alx-1/technologies-de-la-fete/images/TTGO_esp32_pinouts.png

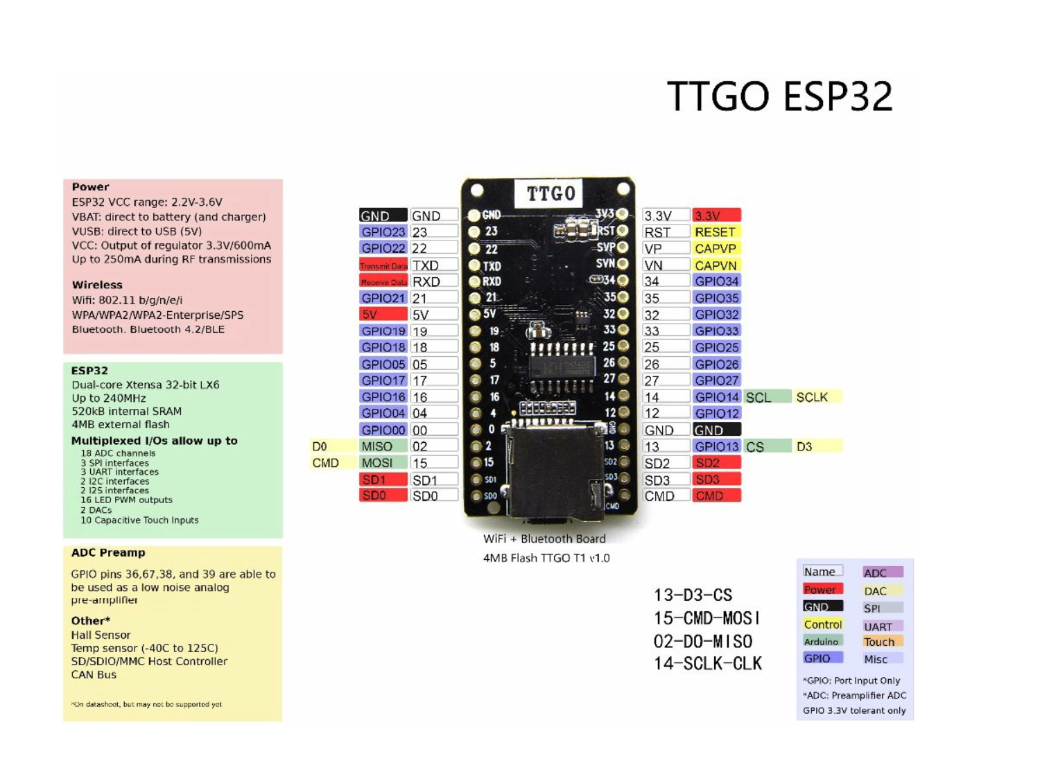
images/TTGO_esp32_pinouts.png
