alx-1/technologies-de-la-fete/README.md

# technologies-de-la-fete

# The project has moved here : https://gitlab.com/tdlf

ESP32 Ableton Link Midi clock, sensor interface and modular sequencer.

Wiki : https://github.com/alx-1/technologies-de-la-fete/wiki
