alx-1/technologies-de-la-fete/software/link_tdlf_client/README.md

# Ableton Link on ESP32 send midi data to server

16 step wireless modular sequencer 
sends midi data via socket
Uses smart config, need the app from Espressif to configure the IP

Tested with esp-idf release/v4.0.

Based on the ESP32 Ableton Link port by Mathias Bredholt https://github.com/mathiasbredholt/link-esp
