alx-1/technologies-de-la-fete/images/ESPTOUCH.PNG

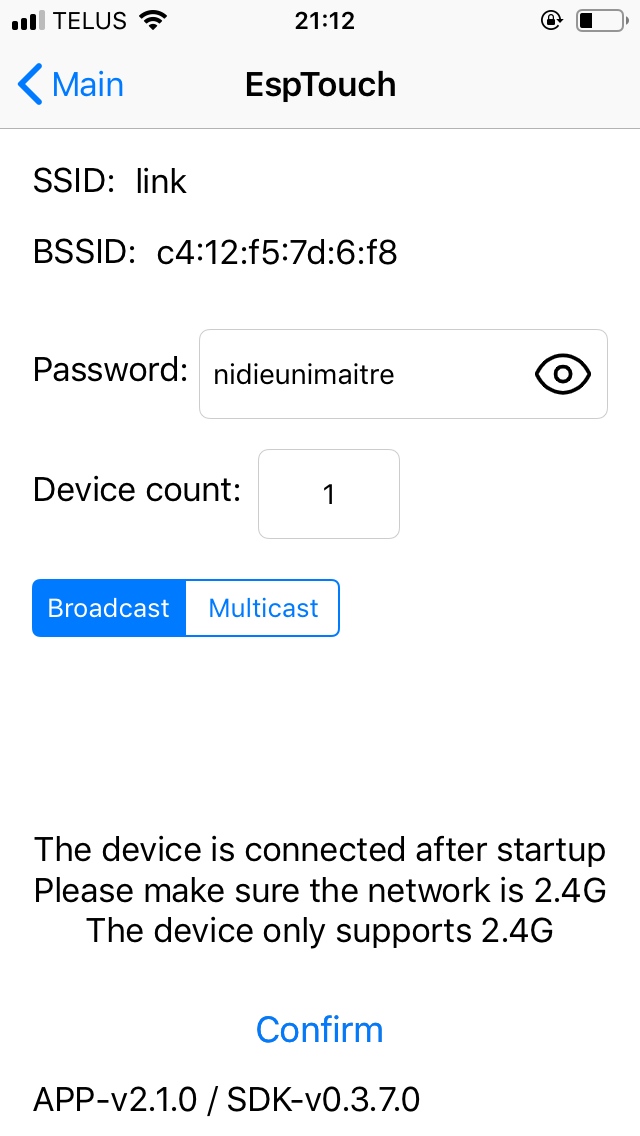
images/ESPTOUCH.PNG
