alx-1/technologies-de-la-fete/images/link_tdlf_client_3D.png

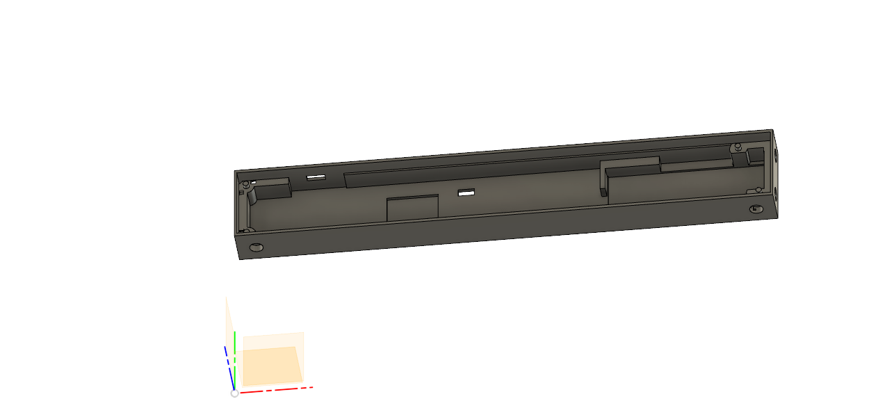
images/link_tdlf_client_3D.png
