alx-1/technologies-de-la-fete/images/midi_data.png

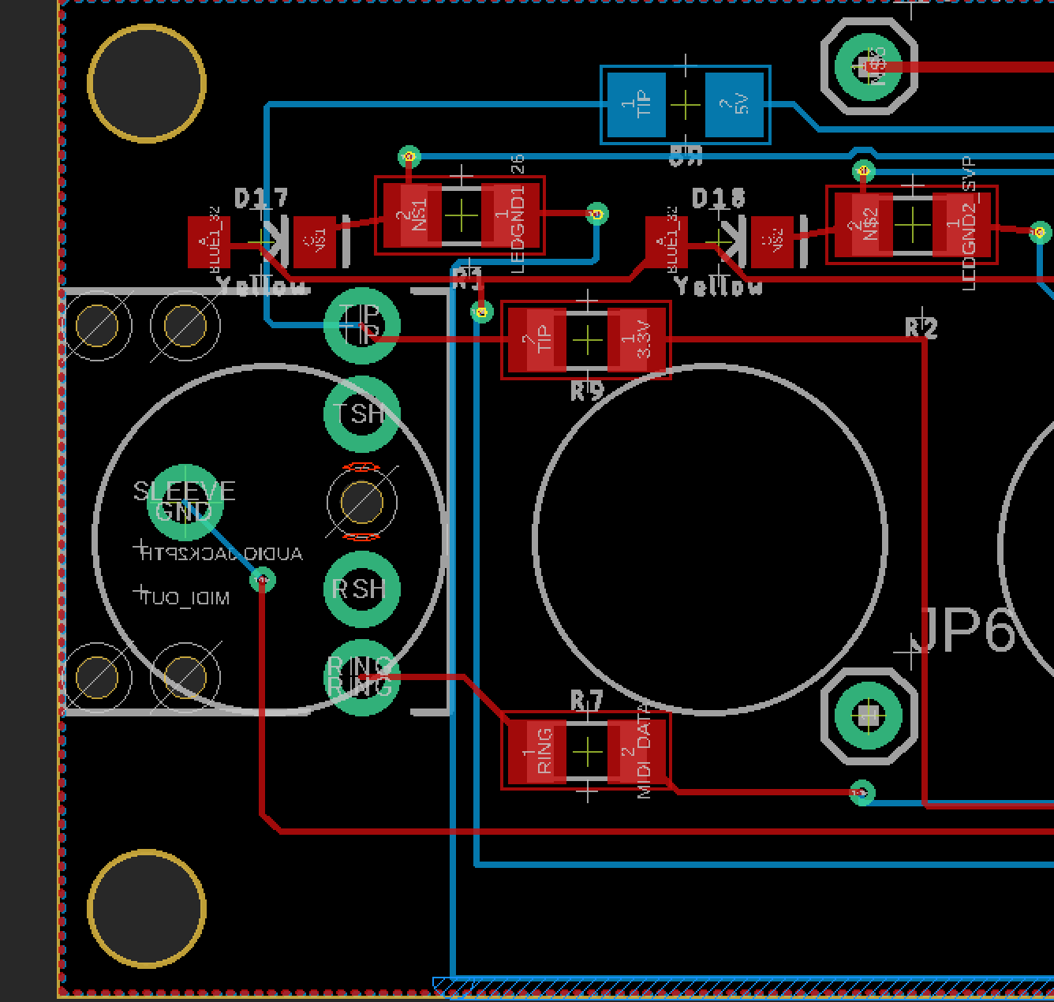
images/midi_data.png
