alx-1/technologies-de-la-fete/images/tdlf.gif

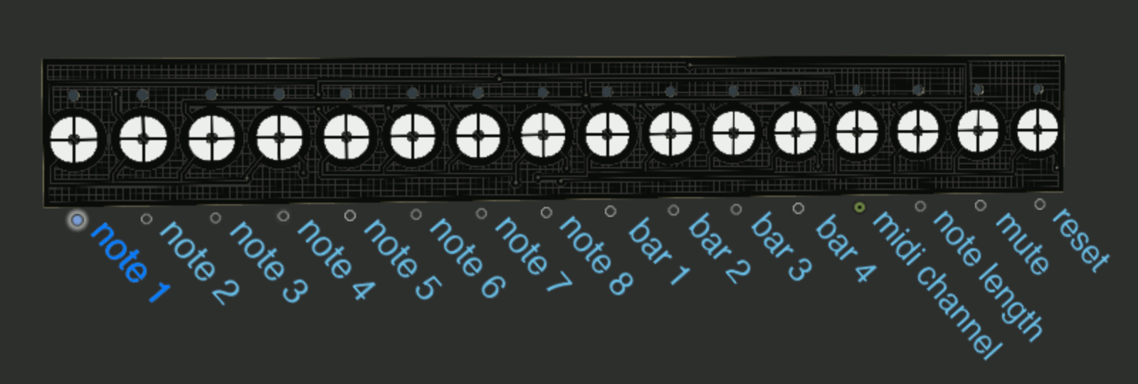
images/tdlf.gif
