alx-1/technologies-de-la-fete/images/tdlf_01.JPG

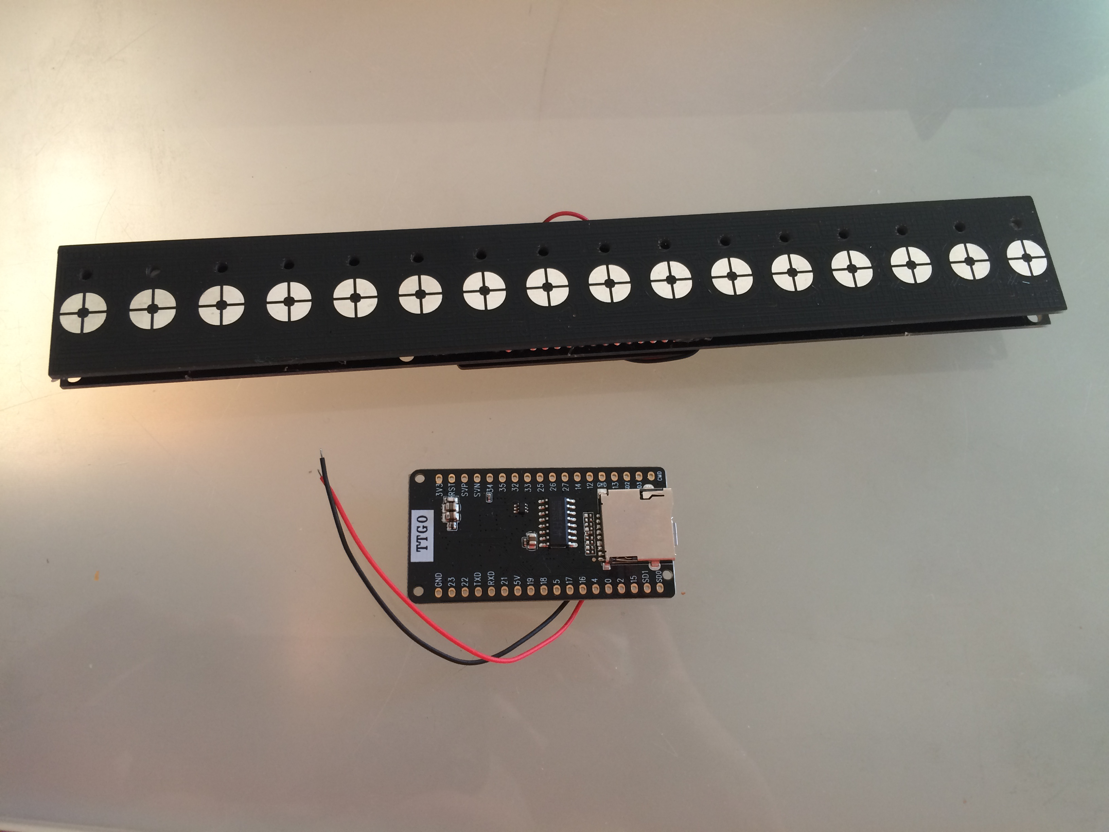
images/tdlf_01.JPG
