alx-1/technologies-de-la-fete/images/tdlf_02.JPG

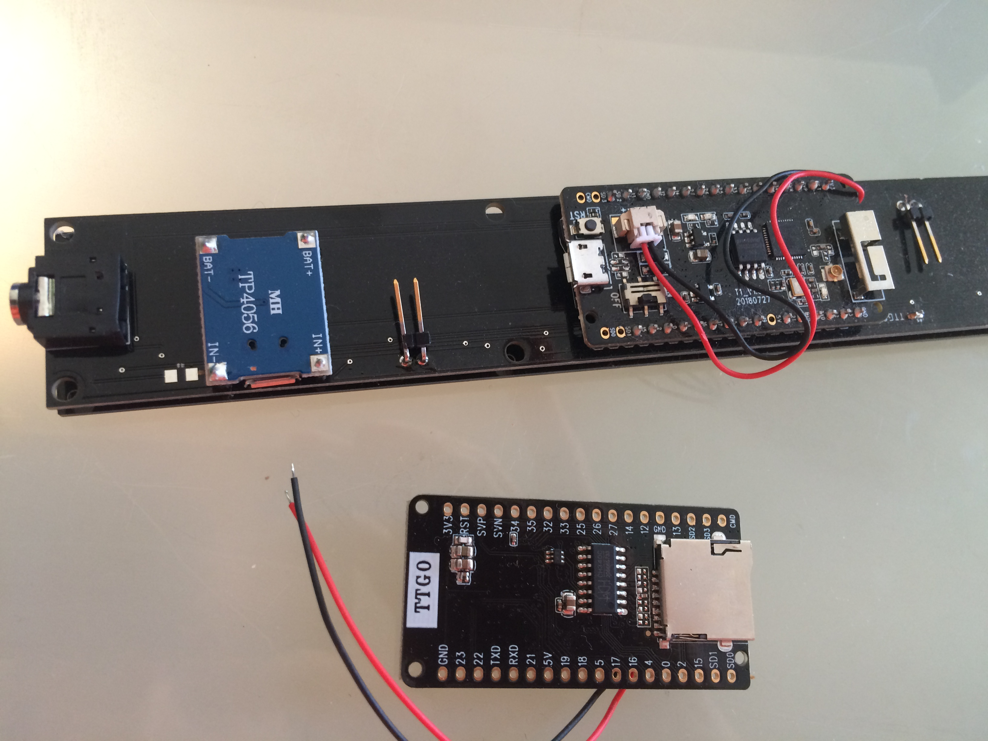
images/tdlf_02.JPG
