alx-1/technologies-de-la-fete/images/tdlf_06_02_2020_TOUCH.png

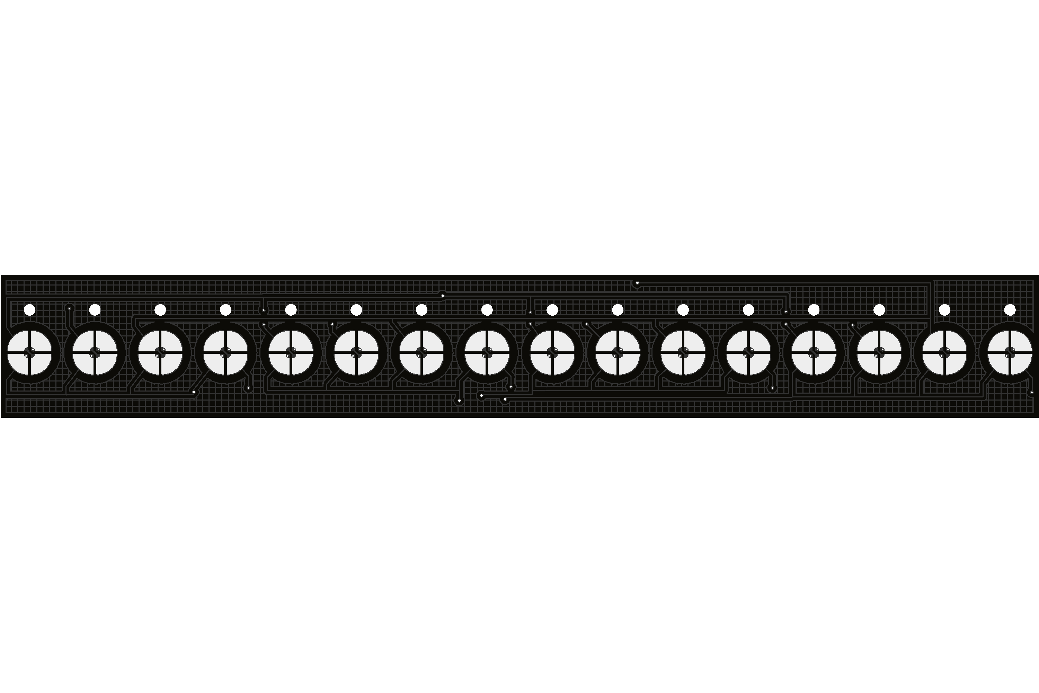
images/tdlf_06_02_2020_TOUCH.png
