alx-1/technologies-de-la-fete/images/tdlf_11_04_2021_TOUCH_UI v5.png

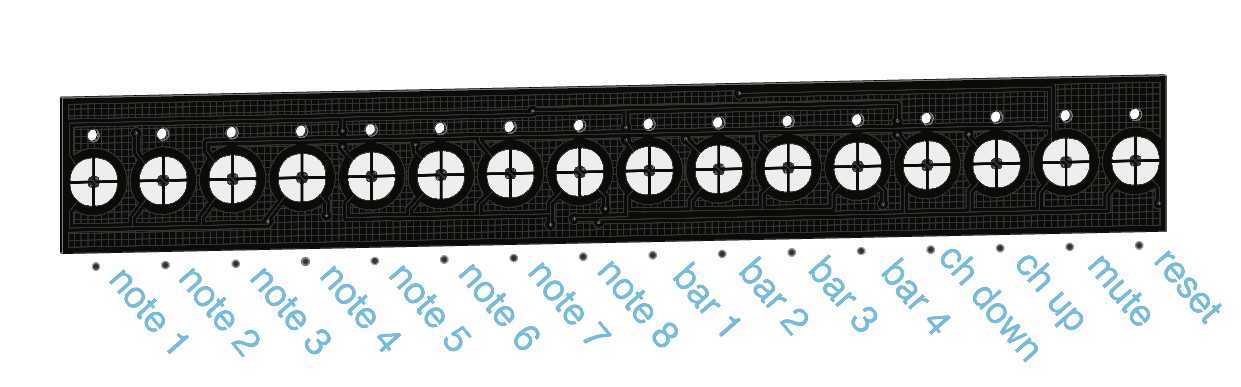
images/tdlf_11_04_2021_TOUCH_UI v5.png
