alx-1/technologies-de-la-fete/images/tdlf_basic_op.png

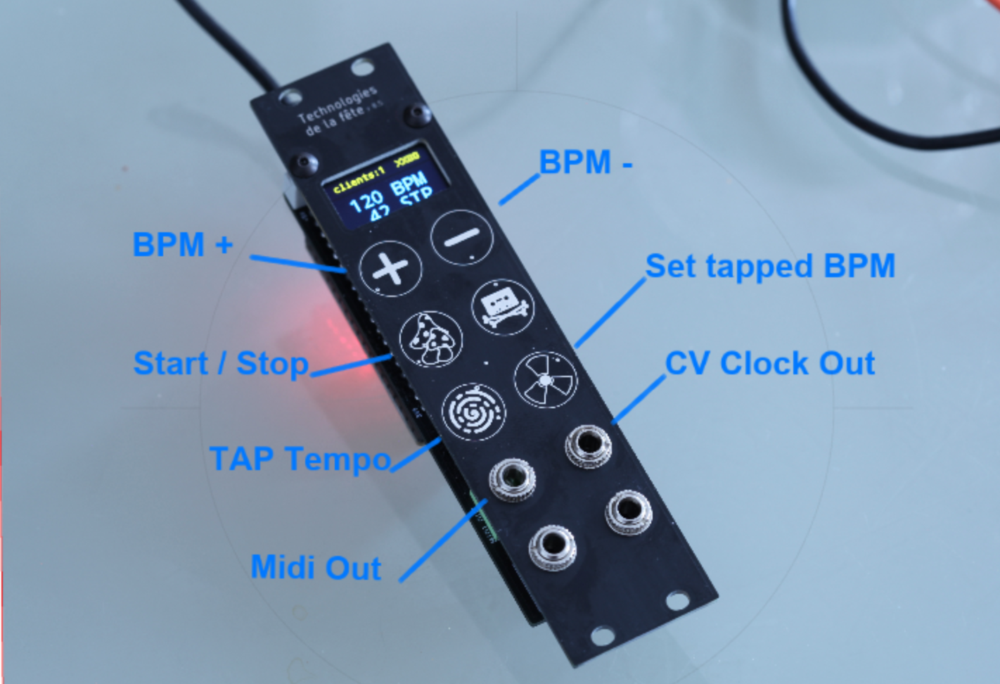
images/tdlf_basic_op.png
