alx-1/technologies-de-la-fete/images/tdlf_board_v_05.png

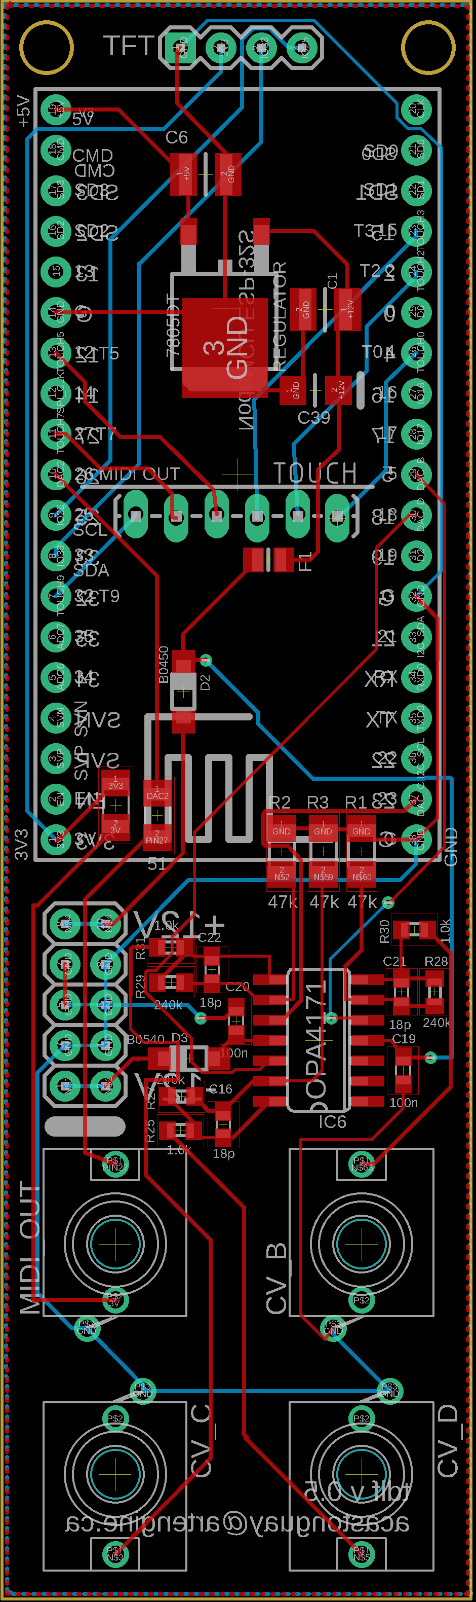
images/tdlf_board_v_05.png
