alx-1/technologies-de-la-fete/images/tdlf_dev_ESP32.png

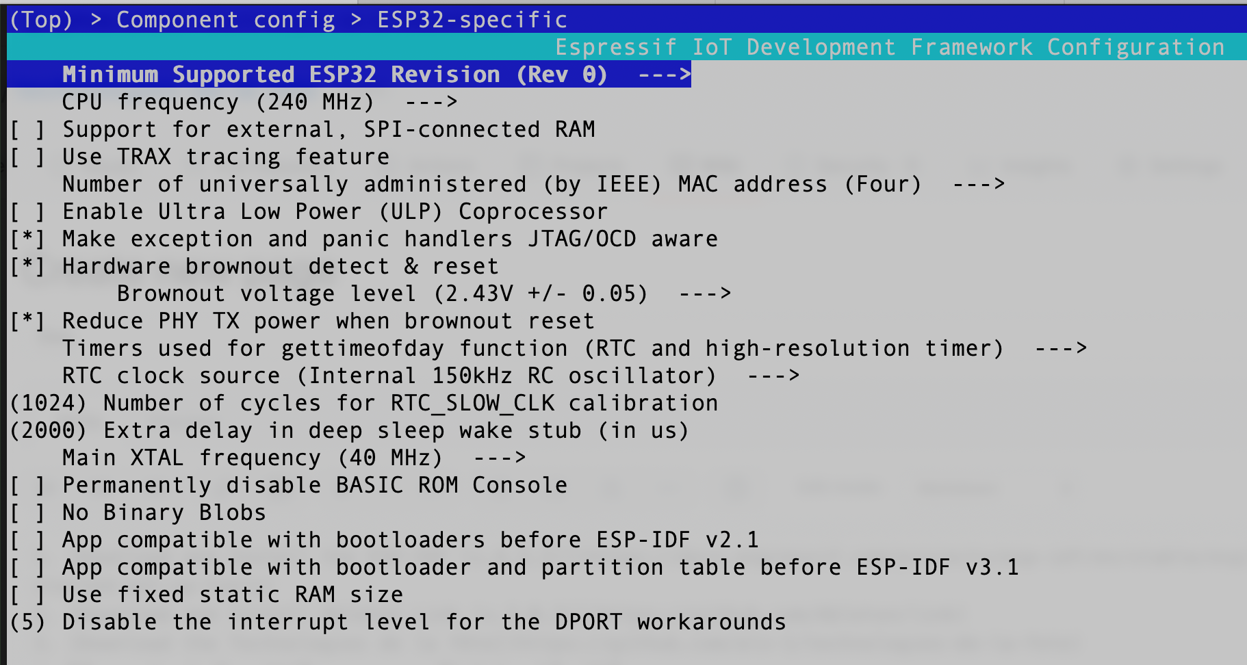
images/tdlf_dev_ESP32.png
