alx-1/technologies-de-la-fete/images/tdlf_dev_partition.png

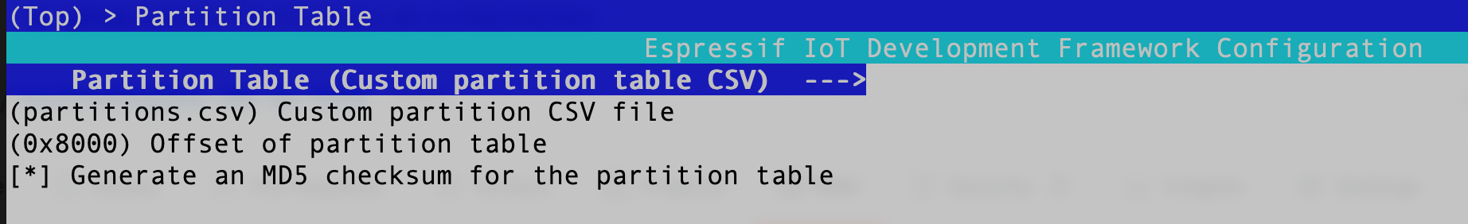
images/tdlf_dev_partition.png
