alx-1/technologies-de-la-fete/images/tdlf_dev_tarableSSD1306.png

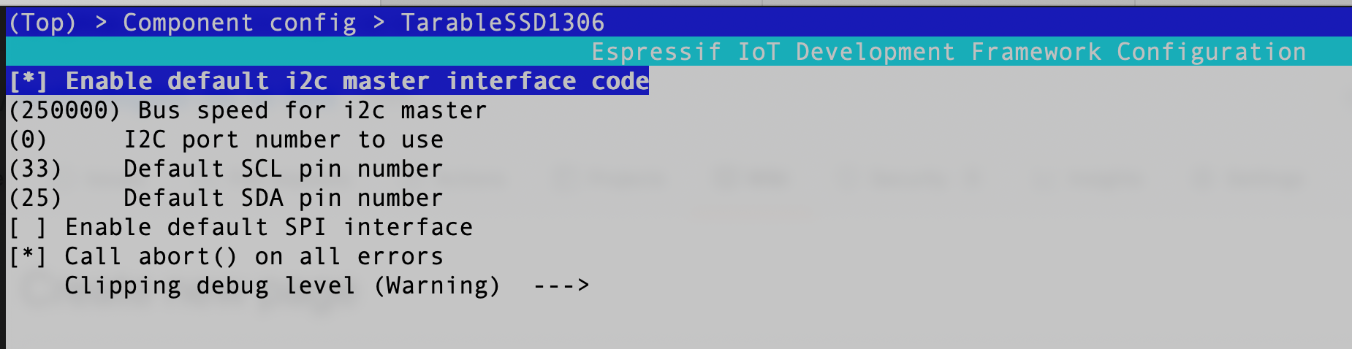
images/tdlf_dev_tarableSSD1306.png
