alx-1/technologies-de-la-fete/images/tdlf_dev_tick.png

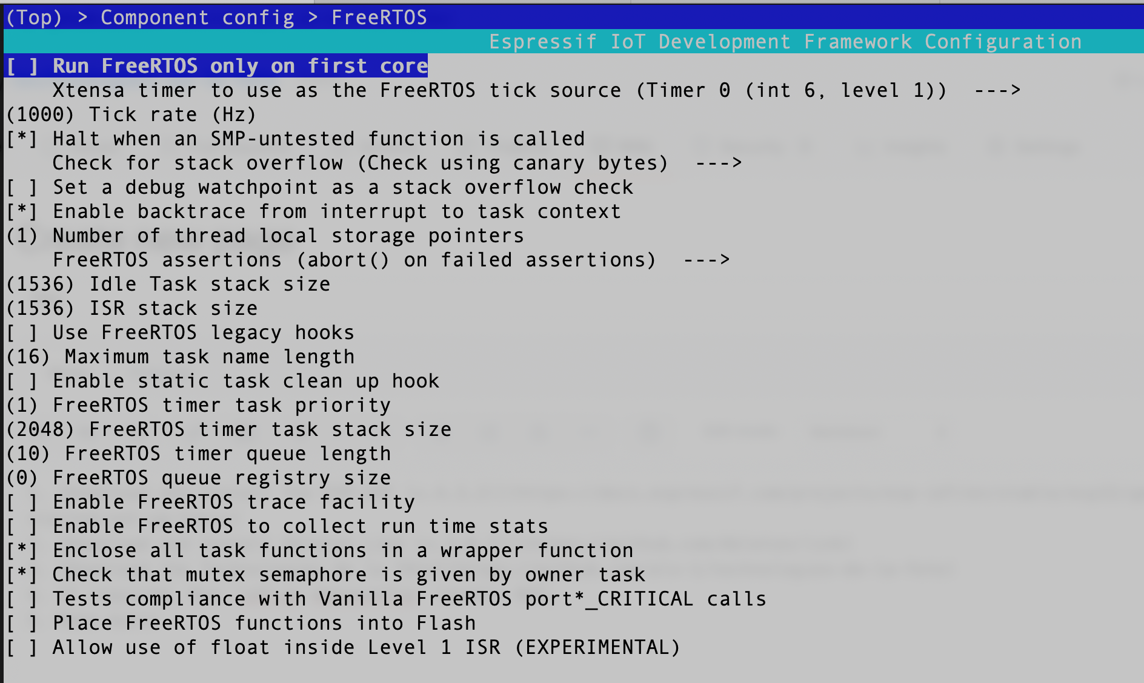
images/tdlf_dev_tick.png
