alx-1/technologies-de-la-fete/images/tdlf_ecosysteme.JPG

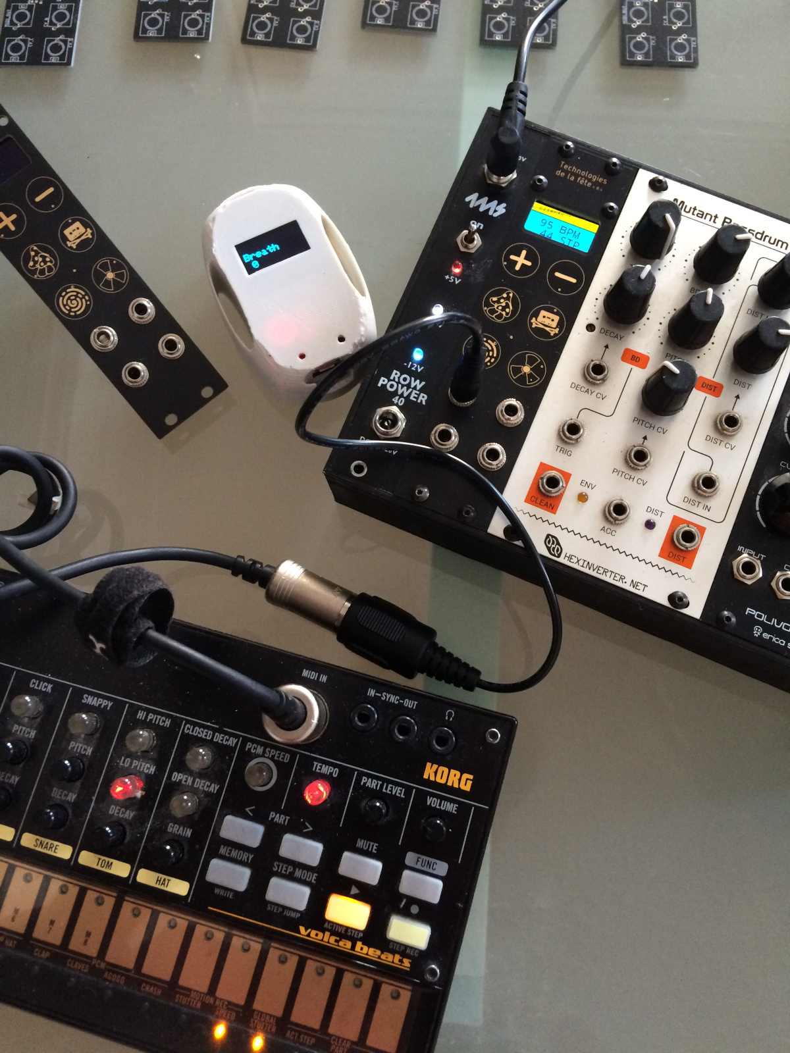
images/tdlf_ecosysteme.JPG
