alx-1/technologies-de-la-fete/images/tdlf_ESP32_WiFI_access_point.jpeg

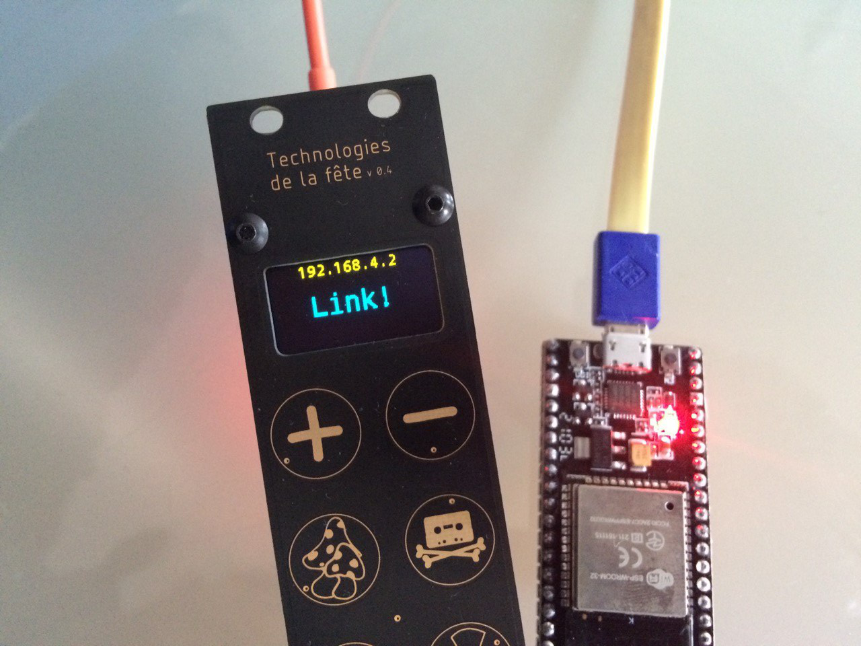
images/tdlf_ESP32_WiFI_access_point.jpeg
