alx-1/technologies-de-la-fete/images/tdlf_ESP32_WIFI_AP.png

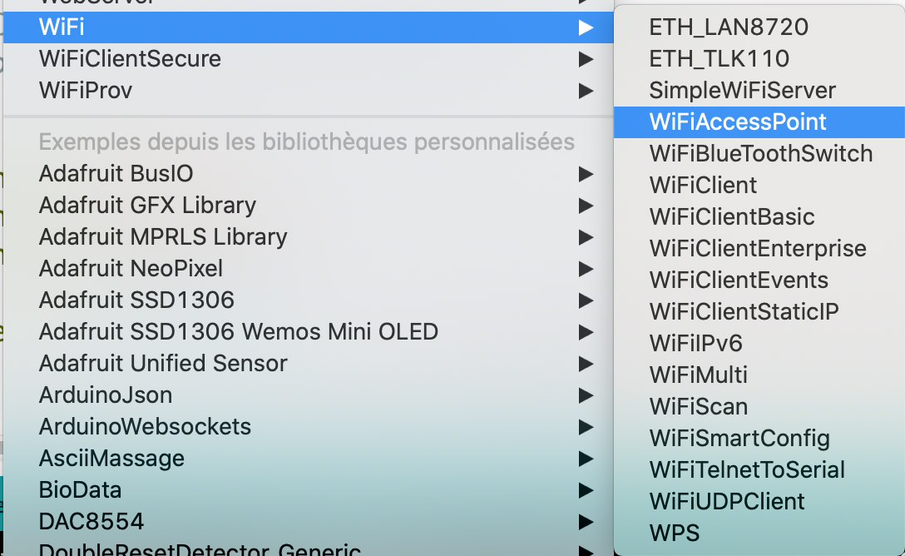
images/tdlf_ESP32_WIFI_AP.png
