alx-1/technologies-de-la-fete/images/tdlf_js_client.png

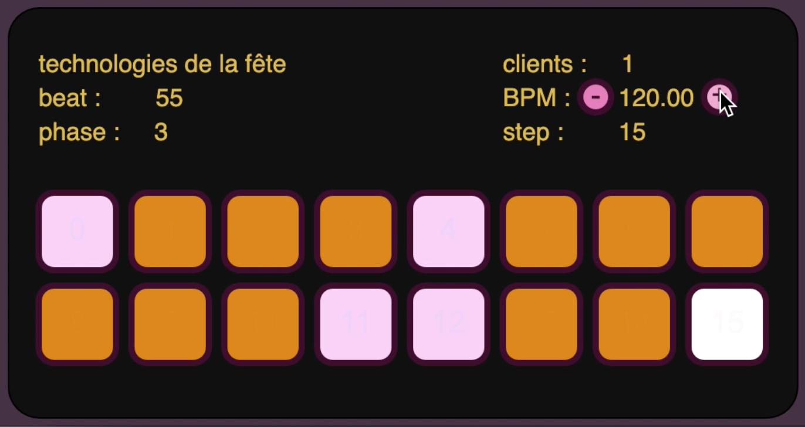
images/tdlf_js_client.png
