alx-1/technologies-de-la-fete/images/tdlf_sensor_op.png

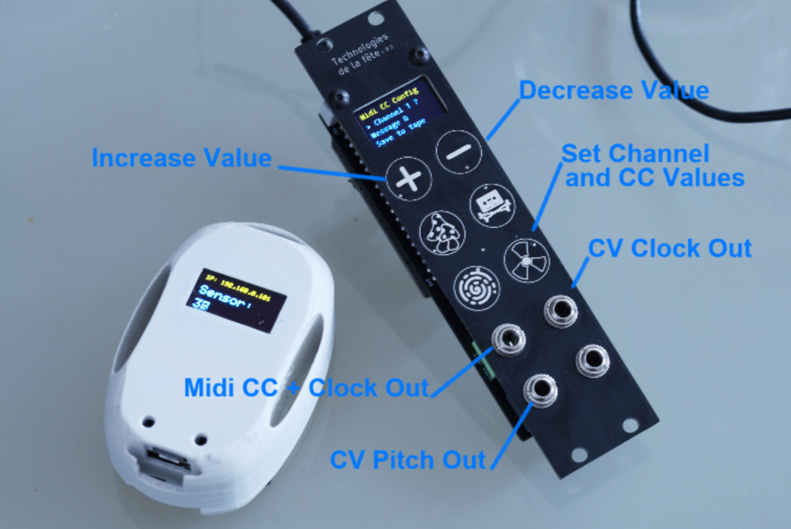
images/tdlf_sensor_op.png
