alx-1/technologies-de-la-fete/images/tdlf_server.jpeg

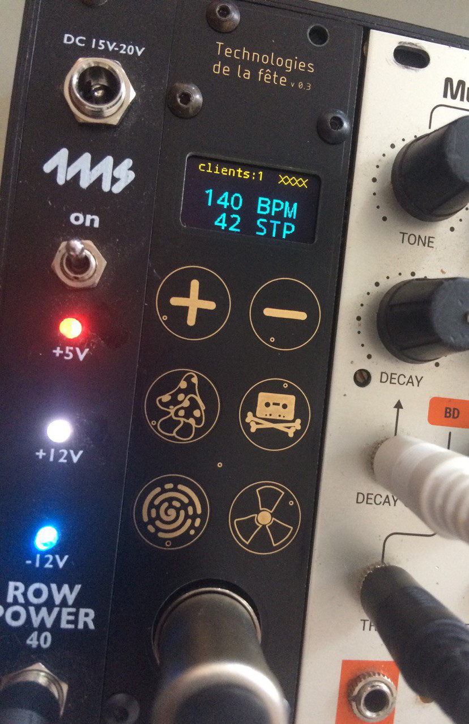
images/tdlf_server.jpeg
