alx-1/technologies-de-la-fete/images/tdlf_server_CV.JPG

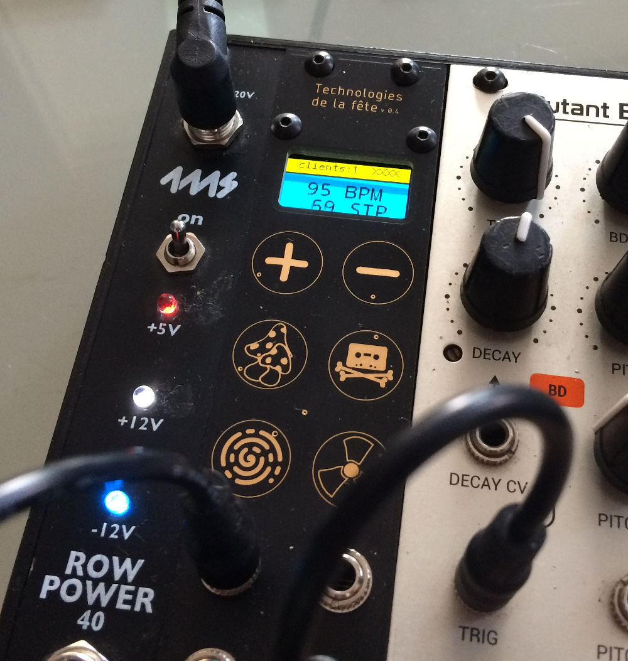
images/tdlf_server_CV.JPG
