alx-1/technologies-de-la-fete/images/tdlf_wifi_mydlink.jpeg

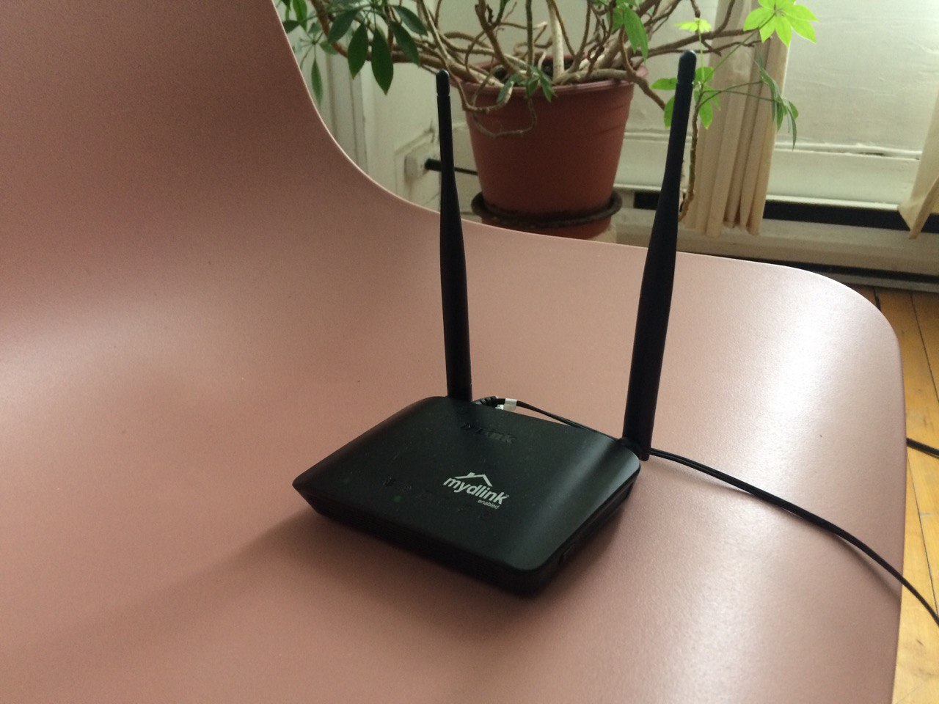
images/tdlf_wifi_mydlink.jpeg
