alx-1/technologies-de-la-fete/hardware/tdlf_server/BOM_tdlf_server.ods

Part | Value | Device | Package | Description | Source | SPICEPREFIX | COST | NUMBER OF PARTS | AGGREGATE COST | INVENTORY | OTHER
Tdlf - Top |  | PCB |  | See github |  |  | 4 | 1 | 4 | 20 | https://github.com/alx-1/technologies-de-la-fete/
Tdlf - Bottom |  | PCB |  | See github |  |  | 4 | 1 | 4 | 20
51K, 51k | 51k | RESISTOR1206 | 1206 | Generic Resistor Package | Digikey | CR1206-JW-510ELFCT-ND‎ (https://www.digikey.ca/product-detail/en/CR1206-JW-510ELF/CR1206-JW-510ELFCT-ND/4248014?itemSeq=385817057) | 0,15 | 2 | 0,3 | 9
R1, R2, R3 | 47k | R-US_R1206 | R1206 | RESISTOR | Digikey | ‎541-47KECT-ND‎ | 0,15 | 3 | 0,45 | 60
R25, R30, R31 | 1.0k | R-US_R0603 | R0603 | RESISTOR | Digikey | ‎YAG3646CT-ND‎ | 0,15 | 3 | 0,45 | 70
R27, R28, R29 | 240k | R-US_R0603 | R0603 | RESISTOR | Digikey | ‎13-AC0603FR-07240KLCT-ND‎ | 0,15 | 3 | 0,45 | 70
C1, C6 | 10uF | CAPACITOR1210 | R1210 | CAPACITOR | Digikey | ‎732-6427-1-ND‎ (https://www.digikey.ca/product-detail/en/875105444001/732-6427-1-ND/5147978?itemSeq=385817232) | 0,9 | 2 | 1,8 | 0
C18, C19, C20 | 100n 0,1uf | C-USC0603 | C0603 | CAPACITOR | Digikey | 1276-CL10B104KB8NNNLCT-ND CAP CER 0.1UF 50V | 0,14 | 3 | 0,42 | 50 | https://www.digikey.ca/en/products/detail/samsung-electro-mechanics/CL10B104KB8NNNL/3894274
C16, C21, C22 | 18p | C-USC0603 | C0603 | CAPACITOR | Digikey | ‎1292-1494-1-ND‎ | 0,14 | 3 | 0,42 | 7 | 50V
C39 | 22uF | CAP_POL1206_TANT | 1206_POL | CAPACITOR | Digikey | ‎718-1995-1-ND‎ | 1 | 1 | 1 | 10 | 22uF Cap Tant Poly 4V ! 1206 | ‎718-1995-1-ND‎ (https://www.digikey.ca/product-detail/en/T55A226M004C0200/718-1995-1-ND/4989591?itemSeq=385817022)
D2,D3 | B0450 | DIODE-SOD123 | SOD123 | DIODE | Digikey | 641-1690-2-ND | 0,51 | 2 | 1,02 | 0
F1 | Worth Electronics 742792664 | FERRITE-BEAD0805 | R0805 | Ferrite bead | Digikey | ‎732-1620-1-ND‎ (https://www.digikey.ca/product-detail/en/742792040/732-1620-1-ND/1639564?itemSeq=385817521) | 0,3 | 1 | 0,3 | 0
IC6 | OPA4171 | TL074D | SO14 | OP AMP | Digikey | 497-1557-1-ND | 0,78 | 1 | 0,78 | 0
MIDI_OUT | WQP-PJ301M-12_JACK | WQP-PJ301M-12_JACK | WQP-PJ301M-12_JACK |  | Thonkiconns | Green Thonkiconn Stereo 3.5mm Audio Jacks (PJ366ST) | 1 | 1 | 1 | 15
CV_B, CV_C, CV_D | WQP-PJ301M-12_JACK | WQP-PJ301M-12_JACK | WQP-PJ301M-12_JACK |  | Thonkiconns | Thonkiconn Mono 3.5mm Audio Jacks (PJ398SM) (x1) | 1 | 3 | 3 | 2
PWR_10 | POWER_SIMPLE10 | POWER_SIMPLE10 | POWER_10 | Male pins (2 x 5) |  |  | 0,3 | 2 | 0,6 | 10
ESP32 | ESP32DEVKITC | ESP32DEVKITC | ESP32-DEVKITC |  | Alibaba |  | 9 | 1 | 9 | 15 | https://www.aliexpress.com/snapshot/0.html?orderId=8142301700379218&productId=1005002870608252
LCD Screen | TFT SCREEN |  |  |  |  |  | 4 | 1 | 4 | 15 | https://www.aliexpress.com/snapshot/0.html?orderId=8143134042339218&productId=32643950109
REGULATOR | 7805DT | 7805DT | TO252 | Positive VOLTAGE REGULATOR | Digikey | MC7805BDTRKG | 1 | 1 | 1 | 0
TFT |  | M04PTH | 1X04 | Header 4 | Digikey |  | 0,2 | 1 | 0,2
TOUCH |  | M06LOCK_LONGPADS | 1X06_LOCK_LONGPADS | Header 6 | Digikey |  | 0,2 | 1 | 0,2
 |  |  |  |  |  | Total |  |  | 34,39
