alx-1/technologies-de-la-fete/hardware/tdlf_client/link_tdlf_client.step

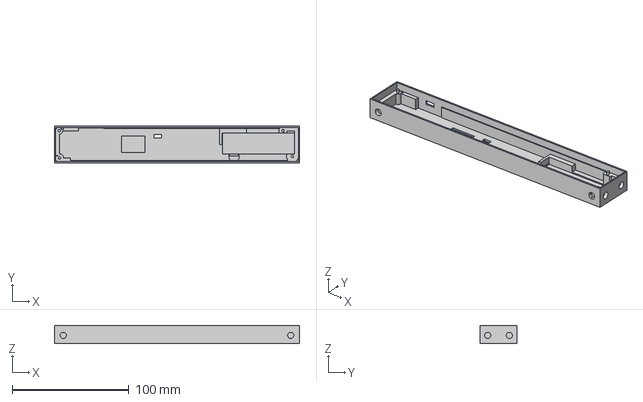
[picture p26: CAD file, 2021-04-11]
hardware/tdlf_client/link_tdlf_client.step
209.5 x 31.5 x 15.5 mm
