alx-1/technologies-de-la-fete/hardware/tdlf_sensor/CajitaAbierta/cajita_3D/bluebox_side.stl

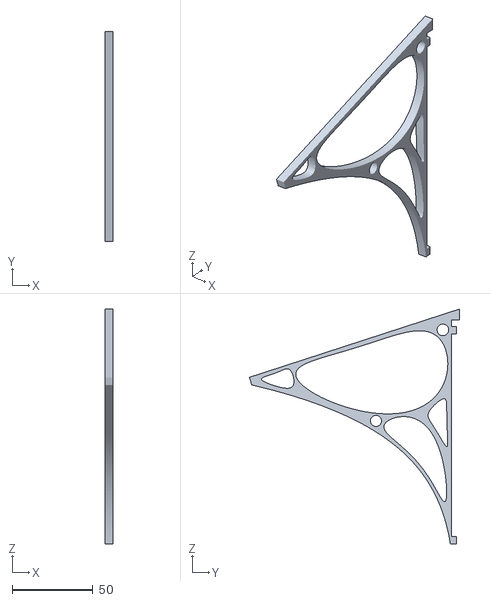
[picture p27: CAD file, 2022-06-09]
hardware/tdlf_sensor/CajitaAbierta/cajita_3D/bluebox_side.stl
5.00 x 130.2 x 145.4
