alx-1/technologies-de-la-fete/(list of files, cad)

Other CAD files:
hardware/tdlf_sensor/CajitaAbierta/cajita_3D/Cajita_abierta_v05.f3d
