alx-1/technologies-de-la-fete/images/cajita_abierta_montaje/c_a_07.png

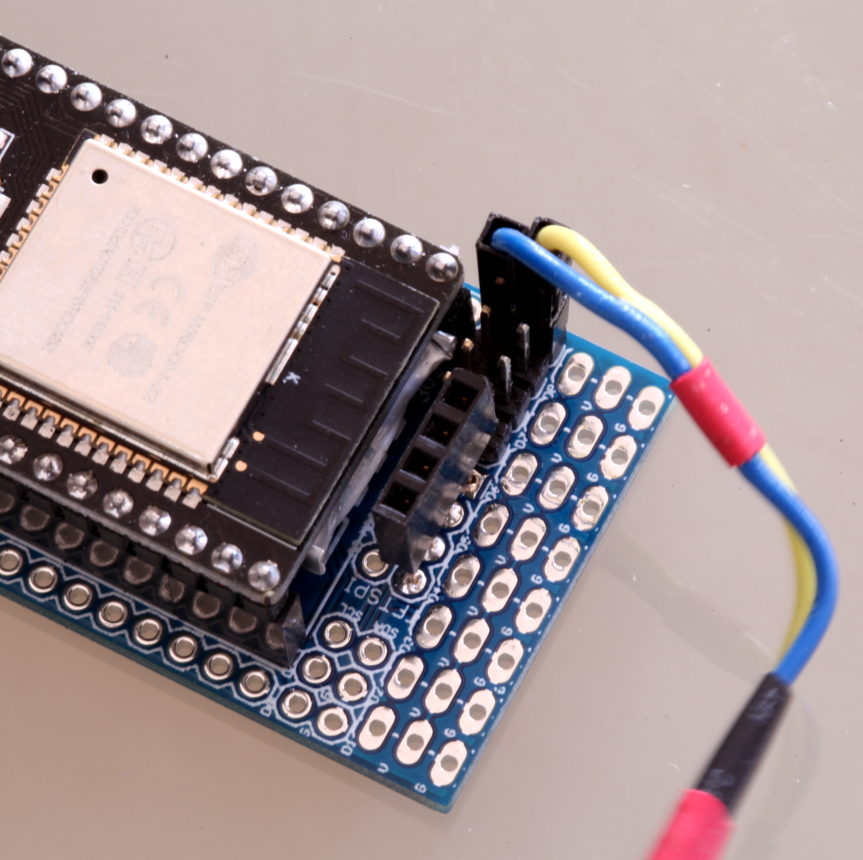
images/cajita_abierta_montaje/c_a_07.png
