alx-1/technologies-de-la-fete/images/link_tdlf_client_assembly.png

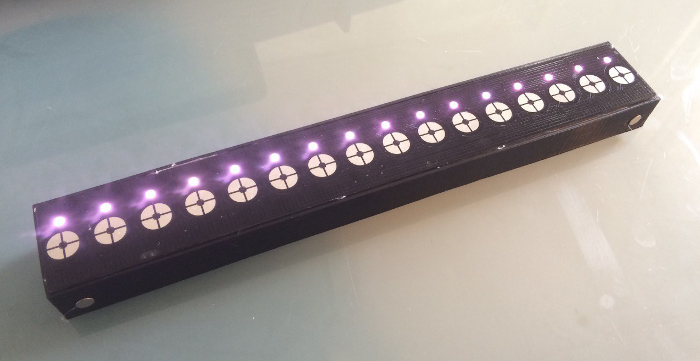
images/link_tdlf_client_assembly.png
