alx-1/technologies-de-la-fete/images/link_tdlf_client_print.jpeg

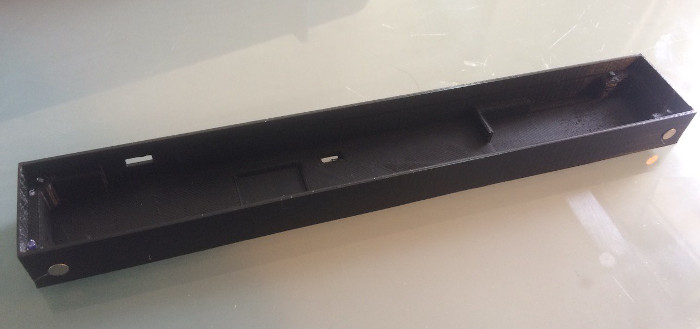
images/link_tdlf_client_print.jpeg
