alx-1/technologies-de-la-fete/hardware/tdlf_steamy_streamer/steamy_streamer_0_2.brd

## EAGLE design hardware/tdlf_steamy_streamer/steamy_streamer_0_2.brd (2022-12-29)

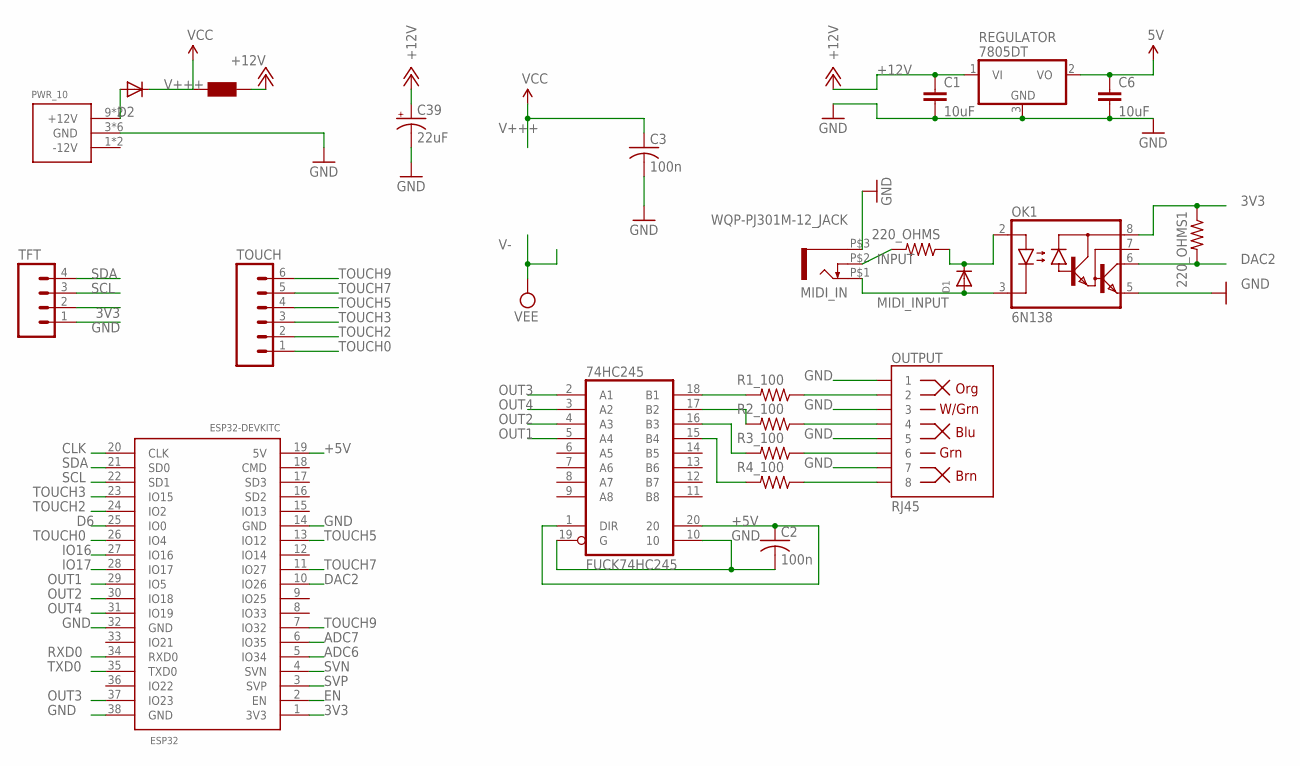
[picture p35: schematic steamy_streamer_0_2.sch]

Parts:
74HC245: FUCK74HC245; SO20W
220_OHMS, 220_OHMS1: 1206
C1, C6: 10uF; R1210
C2, C3: 100n; C1206
C39: 22uF; 1206_POL
D1: DIODESMA; SMADIODE
D2: B0450; SOD123
ESP32: ESP32DEVKITC; ESP32-DEVKITC
F1: Würth Electronics 742792664; R0805
MIDI_IN: WQP-PJ301M-12_JACK
OK1: 6N138; DIL08
OUTPUT: RJ45; RJ45-8
PWR_10: POWER_SIMPLE10; POWER_10
R1_100, R2_100, R3_100, R4_100: RESISTOR1206; 1206
REGULATOR: 7805DT; TO252
TFT: M04PTH; 1X04
TOUCH: M06LOCK_LONGPADS; 1X06_LOCK_LONGPADS

Connections:
3V3: 220_OHMS1.1, ESP32.1 (3V3), OK1.8 (VCC), TFT.2
4: OUTPUT.2, R1_100.1
+5V: 74HC245.1 (DIR), 74HC245.20, C2.1, C6.1, ESP32.19 (5V), REGULATOR.2 (VO)
+12V: C1.1, C39.2 (+), F1.1, REGULATOR.1 (VI)
ADC6: ESP32.5 (IO34)
ADC7: ESP32.6 (IO35)
CLK: ESP32.20 (CLK)
D6: ESP32.25 (IO0)
DAC2: 220_OHMS1.2, ESP32.10 (IO26), OK1.6 (VO)
EN: ESP32.2 (EN)
GND: 74HC245.10, 74HC245.19 (G), C1.2, C2.2, C3.2, C6.2, C39.1 (-), ESP32.14 (GND), ESP32.32 (GND), ESP32.38 (GND), MIDI_IN.P$3 (1), OK1.5 (GND), OUTPUT.1, OUTPUT.3, OUTPUT.5, OUTPUT.7, PWR_10.3 (GND), PWR_10.4 (GND), PWR_10.5 (GND), PWR_10.6 (GND), PWR_10.7 (GND), PWR_10.8 (GND), REGULATOR.3 (GND), TFT.1
INPUT: 220_OHMS.2, MIDI_IN.P$2 (3)
IO16: ESP32.27 (IO16)
IO17: ESP32.28 (IO17)
MIDI_INPUT: D1.A, MIDI_IN.P$1 (2), OK1.3 (C)
unnamed: OUTPUT.8, R4_100.1
unnamed: OUTPUT.6, R3_100.1
unnamed: D2.A, PWR_10.9 (+12V), PWR_10.10 (+12V)
unnamed: OUTPUT.4, R2_100.1
unnamed: 220_OHMS.1, D1.C, OK1.2 (A)
unnamed: 74HC245.18 (B1), R1_100.2
unnamed: 74HC245.17 (B2), R2_100.2
unnamed: 74HC245.16 (B3), R3_100.2
unnamed: 74HC245.15 (B4), R4_100.2
OUT1: 74HC245.5 (A4), ESP32.29 (IO5)
OUT2: 74HC245.4 (A3), ESP32.30 (IO18)
OUT3: 74HC245.2 (A1), ESP32.37 (IO23)
OUT4: 74HC245.3 (A2), ESP32.31 (IO19)
RXD0: ESP32.34 (RXD0)
SCL: ESP32.22 (SD1), TFT.3
SDA: ESP32.21 (SD0), TFT.4
SVN: ESP32.4 (SVN)
SVP: ESP32.3 (SVP)
TOUCH0: ESP32.26 (IO4), TOUCH.1
TOUCH2: ESP32.24 (IO2), TOUCH.2
TOUCH3: ESP32.23 (IO15), TOUCH.3
TOUCH5: ESP32.13 (IO12), TOUCH.4
TOUCH7: ESP32.11 (IO27), TOUCH.5
TOUCH9: ESP32.7 (IO32), TOUCH.6
TXD0: ESP32.35 (TXD0)
V+++: C3.1, D2.C, F1.2

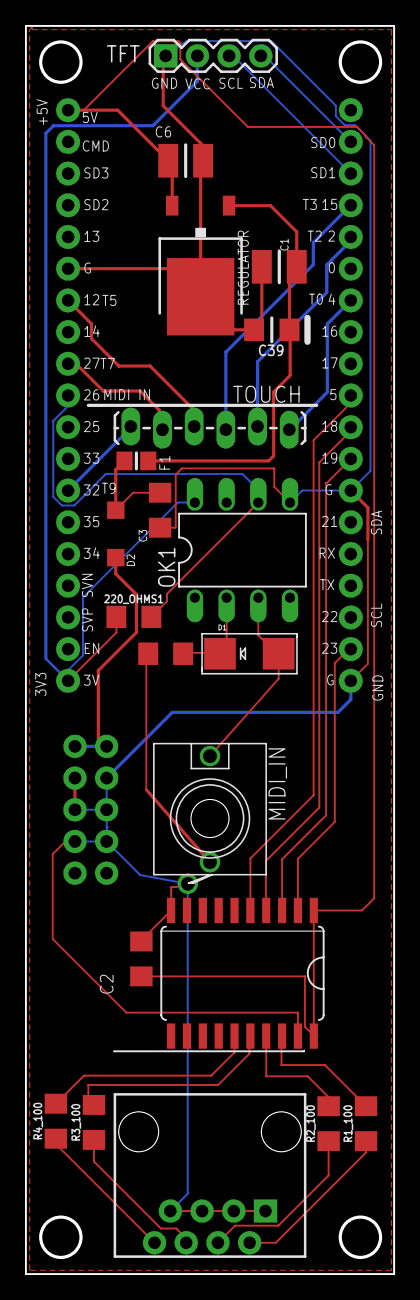
[picture p36: board steamy_streamer_0_2.brd from above]

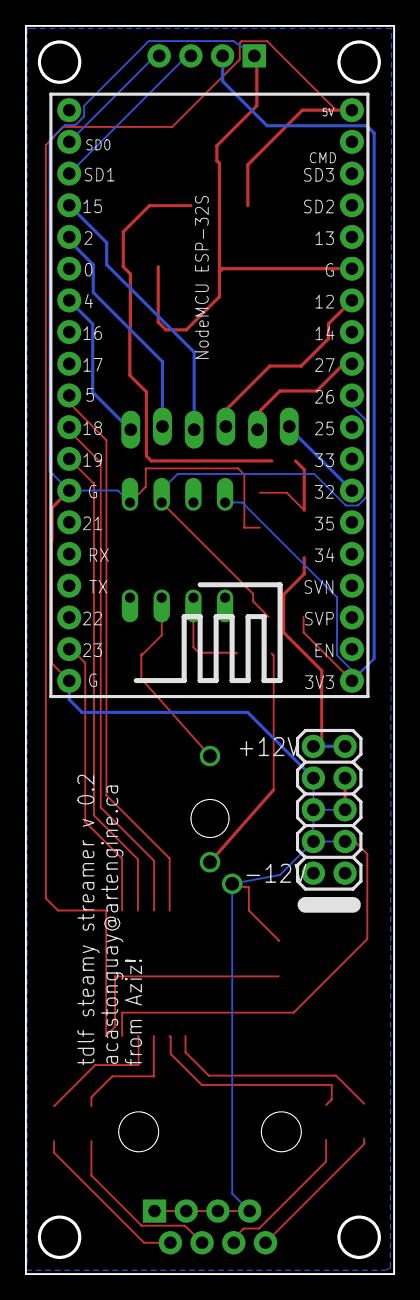
[picture p37: board steamy_streamer_0_2.brd from below]

Board: 2 copper layers, 29.5 x 100.0 mm, 23 parts (2 on the bottom side), 30 nets.
