alx-1/technologies-de-la-fete/hardware/tdlf_steamy_streamer/tdlf_steamy_streamer_top_modulaire.brd

## EAGLE design hardware/tdlf_steamy_streamer/tdlf_steamy_streamer_top_modulaire.brd (2022-12-29)

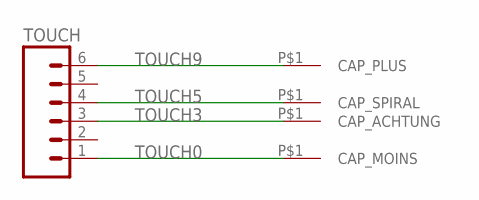
[picture p38: schematic tdlf_steamy_streamer_top_modulaire.sch]

Parts:
CAP_PLUS: TDLF_CAP_PLUS
TOUCH: M06SMD-STRAIGHT-COMBO-FEMALE; 1X06_SMD_STRAIGHT_COMBO
U$1: TDLF_CAP_MOINS
U$2: TDLF_CAP_SPIRAL
U$4: TDLF_CAP_ACHTUNG

Connections:
TOUCH0: TOUCH.1, U$1.P$1
TOUCH3: TOUCH.3, U$4.P$1
TOUCH5: TOUCH.4, U$2.P$1
TOUCH9: CAP_PLUS.P$1, TOUCH.6

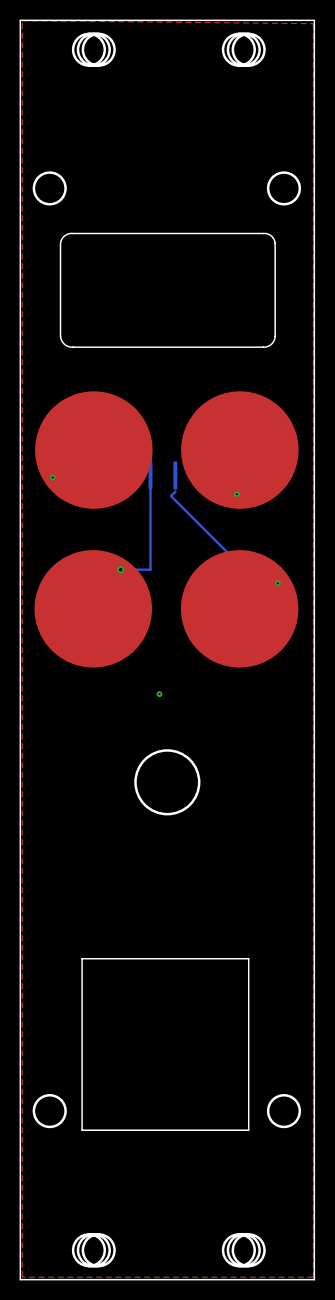
[picture p39: board tdlf_steamy_streamer_top_modulaire.brd from above]

Board: 2 copper layers, 30.0 x 128.5 mm, 5 parts (1 on the bottom side), 4 nets.
