alx-1/technologies-de-la-fete/hardware/tdlf_server/tdlf_server.brd

## EAGLE design hardware/tdlf_server/tdlf_server.brd (2021-12-08)

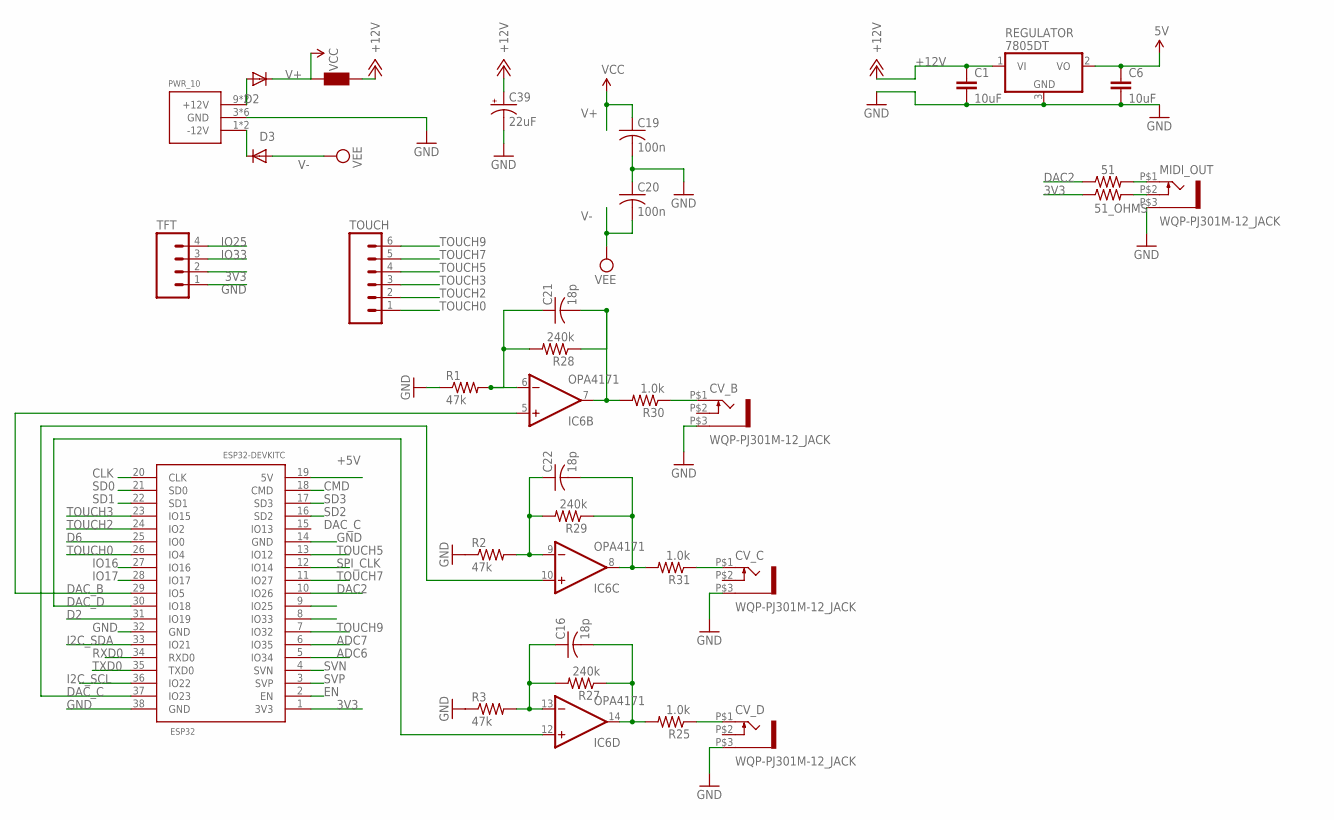
[picture p43: schematic tdlf_server.sch]

Parts:
51, 51_OHMS: 1206
C1, C6: 10uF; R1210
C16, C21, C22: 18p; C0603
C19, C20: 100n; C0603
C39: 22uF; 1206_POL
CV_B: WQP-PJ301M-12_JACK
CV_C: WQP-PJ301M-12_JACK
CV_D: WQP-PJ301M-12_JACK
D2: B0450; SOD123
D3: B0540; SOD123
ESP32: ESP32DEVKITC; ESP32-DEVKITC
F1: Würth Electronics 742792664; R0805
IC6: OPA4171; SO14
MIDI_OUT: WQP-PJ301M-12_JACK
PWR_10: POWER_SIMPLE10; POWER_10
R1, R2, R3: 47k; R1206
R25, R30, R31: 1.0k; R0603
R27, R28, R29: 240k; R0603
REGULATOR: 7805DT; TO252
TFT: M04PTH; 1X04
TOUCH: M06LOCK_LONGPADS; 1X06_LOCK_LONGPADS

Connections:
3V: 51_OHMS.2, MIDI_OUT.P$2 (3)
3V3: 51_OHMS.1, ESP32.1 (3V3), TFT.2
+5V: C6.1, ESP32.19 (5V), REGULATOR.2 (VO)
+12V: C1.1, C39.2 (+), F1.1, REGULATOR.1 (VI)
ADC6: ESP32.5 (IO34)
ADC7: ESP32.6 (IO35)
CLK: ESP32.20 (CLK)
CMD: ESP32.18 (CMD)
D2: ESP32.31 (IO19)
D6: ESP32.25 (IO0)
DAC2: 51.1, ESP32.10 (IO26)
DAC_B: ESP32.29 (IO5), IC6.5 (+IN)
DAC_C: ESP32.37 (IO23), IC6.10 (+IN)
DAC_D: ESP32.30 (IO18), IC6.12 (+IN)
EN: ESP32.2 (EN)
GND: C1.2, C6.2, C19.2, C20.1, C39.1 (-), CV_B.P$3 (1), CV_C.P$3 (1), CV_D.P$3 (1), ESP32.14 (GND), ESP32.32 (GND), ESP32.38 (GND), MIDI_OUT.P$3 (1), PWR_10.3 (GND), PWR_10.4 (GND), PWR_10.5 (GND), PWR_10.6 (GND), PWR_10.7 (GND), PWR_10.8 (GND), R1.1, R2.1, R3.1, REGULATOR.3 (GND), TFT.1
I2C_SCL: ESP32.36 (IO22)
I2C_SDA: ESP32.33 (IO21)
IO16: ESP32.27 (IO16)
IO17: ESP32.28 (IO17)
IO25: ESP32.9 (IO25), TFT.4
IO33: ESP32.8 (IO33), TFT.3
unnamed: D3.C, PWR_10.1 (-12V), PWR_10.2 (-12V)
unnamed: C22.1, IC6.9 (-IN), R2.2, R29.2
unnamed: CV_C.P$1 (2), R31.1
unnamed: D2.A, PWR_10.9 (+12V), PWR_10.10 (+12V)
unnamed: CV_D.P$1 (2), R25.1
unnamed: C21.2, IC6.7 (OUT), R28.1, R30.2
unnamed: C22.2, IC6.8 (OUT), R29.1, R31.2
unnamed: C16.2, IC6.14 (OUT), R25.2, R27.1
unnamed: C16.1, IC6.13 (-IN), R3.2, R27.2
unnamed: C21.1, IC6.6 (-IN), R1.2, R28.2
unnamed: CV_B.P$1 (2), R30.1
PIN27: 51.2, MIDI_OUT.P$1 (2)
RXD0: ESP32.34 (RXD0)
SD0: ESP32.21 (SD0)
SD1: ESP32.22 (SD1)
SD2: ESP32.16 (SD2)
SD3: ESP32.17 (SD3)
SPI_CLK: ESP32.12 (IO14)
SVN: ESP32.4 (SVN)
SVP: ESP32.3 (SVP)
TOUCH0: ESP32.26 (IO4), TOUCH.1
TOUCH2: ESP32.24 (IO2), TOUCH.2
TOUCH3: ESP32.23 (IO15), TOUCH.3
TOUCH5: ESP32.13 (IO12), TOUCH.4
TOUCH7: ESP32.11 (IO27), TOUCH.5
TOUCH9: ESP32.7 (IO32), TOUCH.6
TXD0: ESP32.35 (TXD0)
V+: C19.1, D2.C, F1.2, IC6.4 (V+)
V-: C20.2, D3.A, IC6.11 (V-)

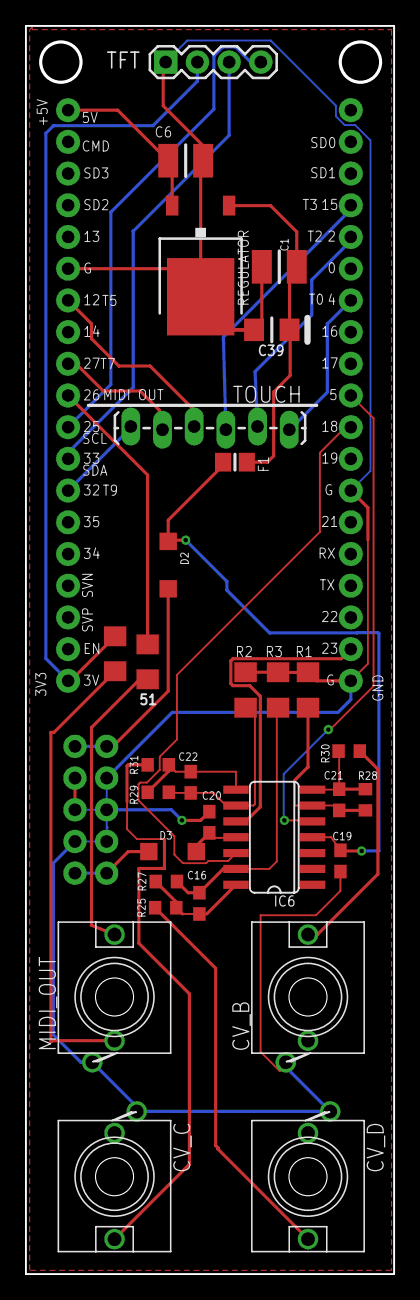
[picture p44: board tdlf_server.brd from above]

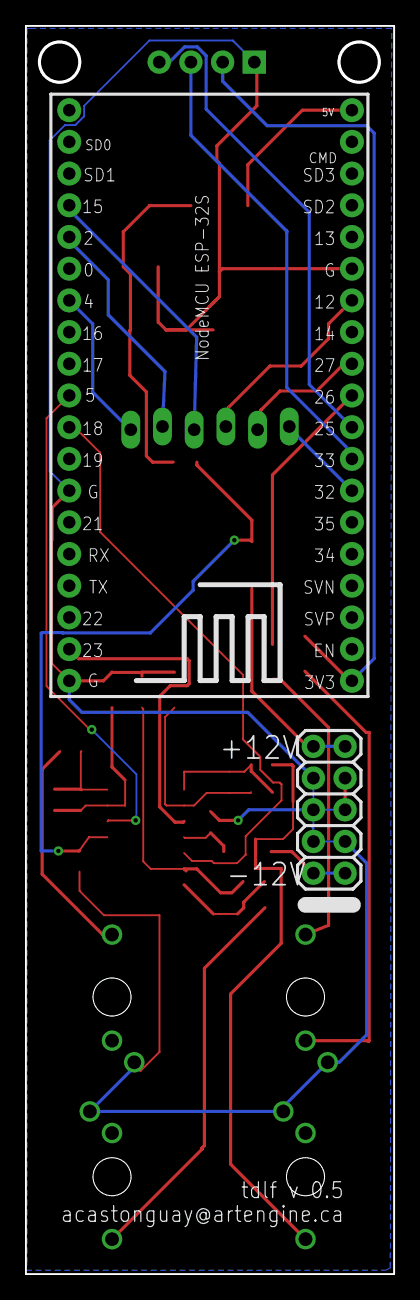
[picture p45: board tdlf_server.brd from below]

Board: 2 copper layers, 29.5 x 100.0 mm, 32 parts (2 on the bottom side), 31 nets.
