alx-1/technologies-de-la-fete/hardware/tdlf_client/tdlf_16_02_2020_LED.brd

## EAGLE design hardware/tdlf_client/tdlf_16_02_2020_LED.brd (2020-10-30)

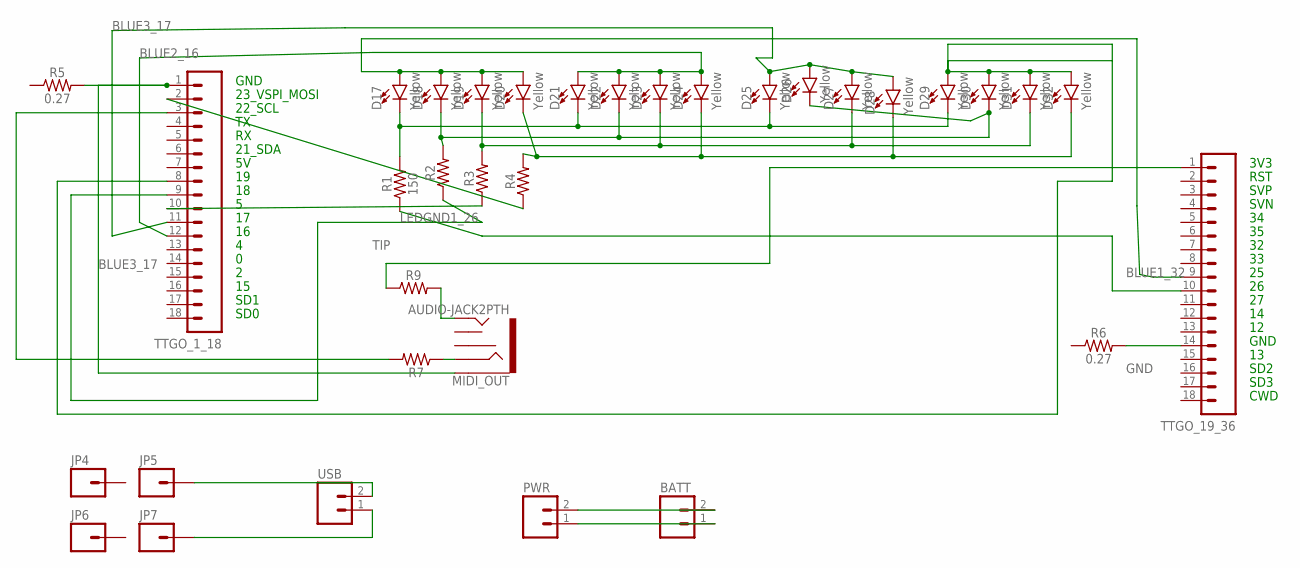
[picture p46: schematic tdlf_16_02_2020_LED.sch]

Parts:
BATT: M02PTH; 1X02
D17, D18, D19, D20, D21, D22, D23, D24, D25, D26, D27, D28, D29, D30, D31, D32: Yellow; LED-1206
JP4, JP5, JP6, JP7: M01PTH; 1X01
MIDI_OUT: AUDIO-JACK2PTH; AUDIO-JACK
PWR: M02PTH; 1X02
R1: 150; 1206
R2, R3, R4, R7, R9: 1206
R5, R6: 0.27; 0603
TTGO_1_18, TTGO_19_36: M18_; 1X18
USB: M02PTH; 1X02

Connections:
3.3V: R9.1, TTGO_19_36.1
BLUE1_32: D17.A, D18.A, D19.A, D20.A, TTGO_19_36.9
BLUE2_16: D21.A, D22.A, D23.A, D24.A, TTGO_1_18.12
BLUE3_17: D25.A, D26.A, D27.A, D28.A, TTGO_1_18.11
BLUE4_34: D29.A, D30.A, D31.A, D32.A, TTGO_1_18.8
GND: MIDI_OUT.SLEEVE, R5.2, R6.2, TTGO_1_18.1, TTGO_19_36.14
LEDGND1_26: R1.1, TTGO_19_36.10
LEDGND2_SVP: R2.1, TTGO_1_18.9
LEDGND3_5_VSPI_SS: R3.1, TTGO_1_18.10
LEDGND4_23: R4.1, TTGO_1_18.2
MIDI_DATA: R7.2, TTGO_1_18.3
unnamed: D17.C, D21.C, D25.C, D29.C, R1.2
unnamed: D18.C, D22.C, D26.C, D30.C, R2.2
unnamed: D19.C, D23.C, D27.C, D31.C, R3.2
unnamed: D20.C, D24.C, D28.C, D32.C, R4.2
unnamed: JP5.1, USB.2
unnamed: JP7.1, USB.1
unnamed: BATT.2, PWR.2
unnamed: BATT.1, PWR.1
RING: MIDI_OUT.RING, R7.1
TIP: MIDI_OUT.TIP, R9.2

Notes on the sheet:
3V3
RST
SVP
SVN
GND
SD2
SD3
CWD
23_VSPI_MOSI
22_SCL
21_SDA
SD1
SD0

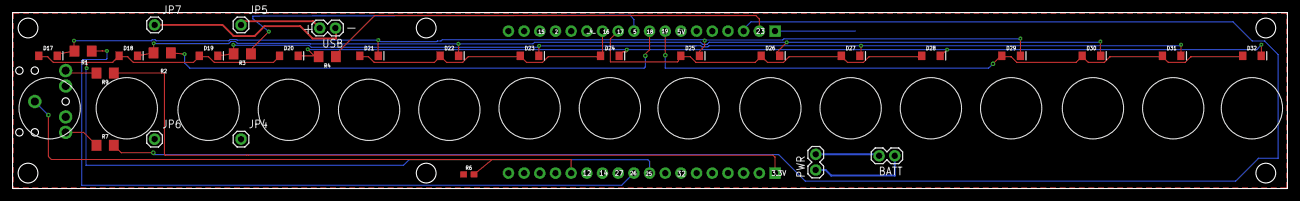
[picture p47: board tdlf_16_02_2020_LED.brd from above]

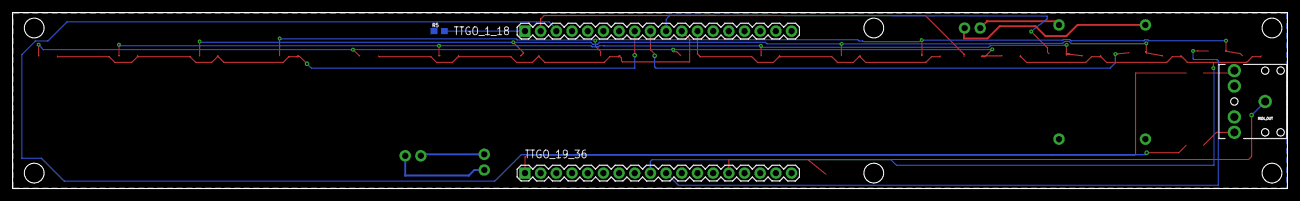
[picture p48: board tdlf_16_02_2020_LED.brd from below]

Board: 2 copper layers, 206.5 x 28.5 mm, 34 parts (4 on the bottom side), 21 nets.
