alx-1/technologies-de-la-fete/hardware/tdlf_client/tdlf_01_04_2020_TOUCH.brd

## EAGLE design hardware/tdlf_client/tdlf_01_04_2020_TOUCH.brd (2020-10-30)

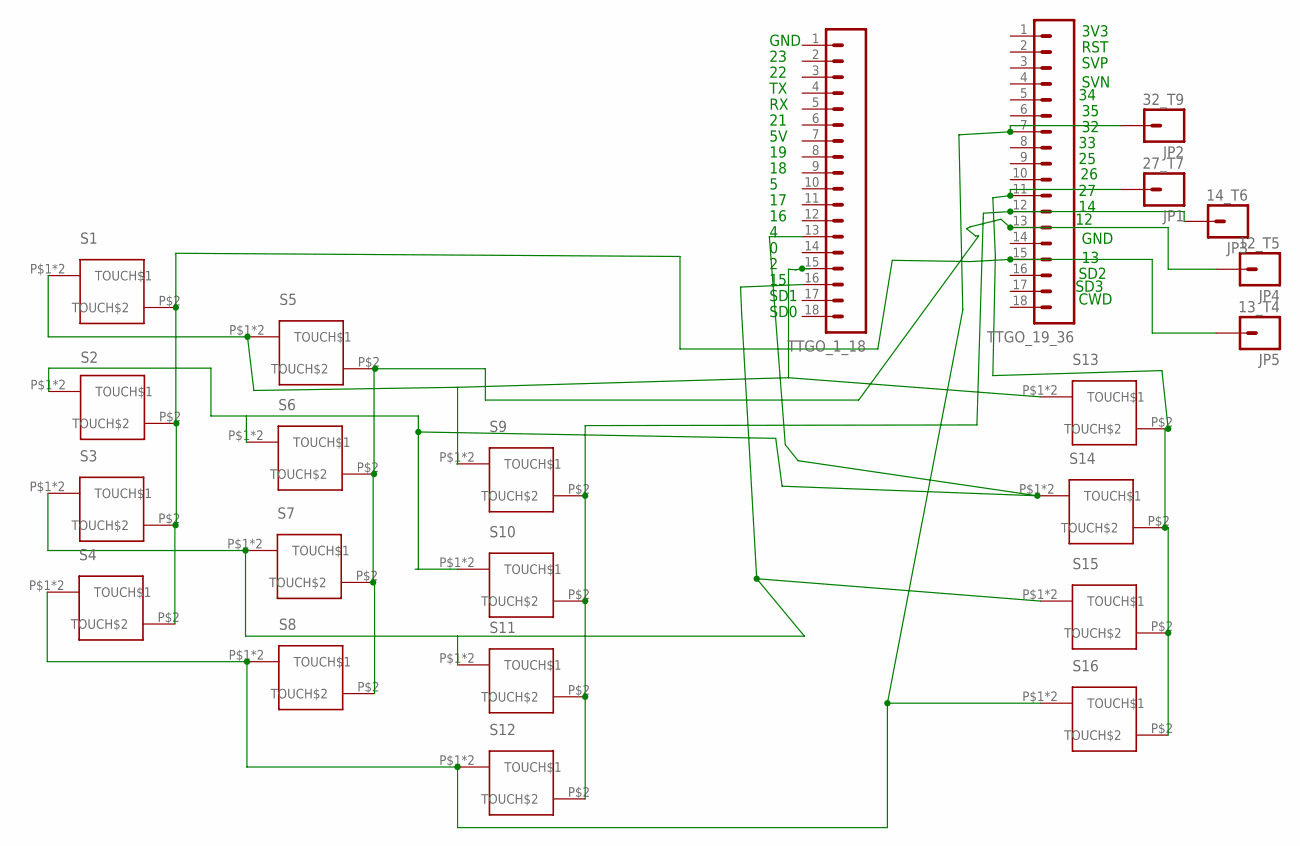
[picture p49: schematic tdlf_01_04_2020_TOUCH.sch]

Parts:
JP1: 27_T7; PAD-1.5X4.5
JP2: 32_T9; PAD-1.5X4.5
JP3: 14_T6; PAD-1.5X4.5
JP4: 12_T5; PAD-1.5X4.5
JP5: 13_T4; PAD-1.5X4.5
S1, S2, S3, S4, S5, S6, S7, S8, S9, S10, S11, S12, S13, S14, S15, S16: DUALCAPACITIVEBUTTON; R1206
TTGO_1_18, TTGO_19_36: M18_; 1X18

Connections:
TOUCH1_0: S2.P$1 (TOUCH$1), S2.P$5 (TOUCH$1), S6.P$1 (TOUCH$1), S6.P$5 (TOUCH$1), S10.P$1 (TOUCH$1), S10.P$5 (TOUCH$1), S14.P$1 (TOUCH$1), S14.P$5 (TOUCH$1), TTGO_1_18.13
TOUCH2_2: S1.P$1 (TOUCH$1), S1.P$5 (TOUCH$1), S5.P$1 (TOUCH$1), S5.P$5 (TOUCH$1), S9.P$1 (TOUCH$1), S9.P$5 (TOUCH$1), S13.P$1 (TOUCH$1), S13.P$5 (TOUCH$1), TTGO_1_18.15
TOUCH3_15: S3.P$1 (TOUCH$1), S3.P$5 (TOUCH$1), S7.P$1 (TOUCH$1), S7.P$5 (TOUCH$1), S11.P$1 (TOUCH$1), S11.P$5 (TOUCH$1), S15.P$1 (TOUCH$1), S15.P$5 (TOUCH$1), TTGO_1_18.16
TOUCH4_13: JP2.P$1, S4.P$1 (TOUCH$1), S4.P$5 (TOUCH$1), S8.P$1 (TOUCH$1), S8.P$5 (TOUCH$1), S12.P$1 (TOUCH$1), S12.P$5 (TOUCH$1), S16.P$1 (TOUCH$1), S16.P$5 (TOUCH$1), TTGO_19_36.7
TOUCH5_12: JP1.P$1, S13.P$2 (TOUCH$2), S14.P$2 (TOUCH$2), S15.P$2 (TOUCH$2), S16.P$2 (TOUCH$2), TTGO_19_36.11
TOUCH6_14: JP3.P$1, S9.P$2 (TOUCH$2), S10.P$2 (TOUCH$2), S11.P$2 (TOUCH$2), S12.P$2 (TOUCH$2), TTGO_19_36.12
TOUCH7_27: JP4.P$1, S5.P$2 (TOUCH$2), S6.P$2 (TOUCH$2), S7.P$2 (TOUCH$2), S8.P$2 (TOUCH$2), TTGO_19_36.13
TOUCH9_32: JP5.P$1, S1.P$2 (TOUCH$2), S2.P$2 (TOUCH$2), S3.P$2 (TOUCH$2), S4.P$2 (TOUCH$2), TTGO_19_36.15

Notes on the sheet:
GND
SD1
SD0
3V3
RST
SVP
SVN
SD2
SD3
CWD

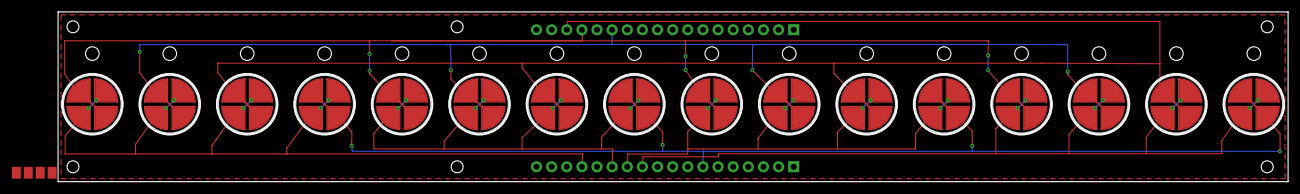
[picture p50: board tdlf_01_04_2020_TOUCH.brd from above]

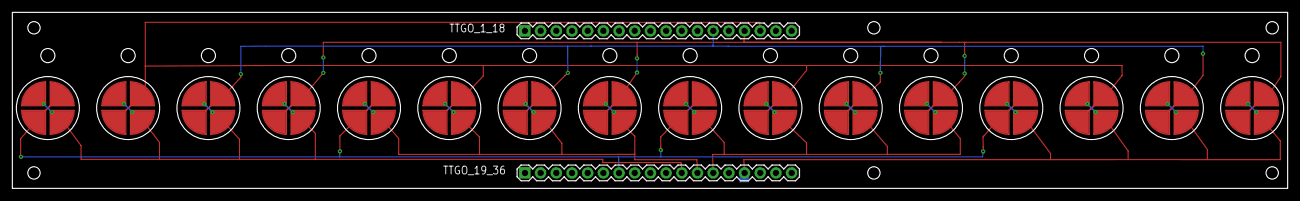
[picture p51: board tdlf_01_04_2020_TOUCH.brd from below]

Board: 2 copper layers, 206.5 x 28.5 mm, 23 parts (3 on the bottom side), 8 nets.
