alx-1/technologies-de-la-fete/hardware/tdlf_server/tdlf_08_15_2021_server_top.brd

## EAGLE design hardware/tdlf_server/tdlf_08_15_2021_server_top.brd (2021-08-17)

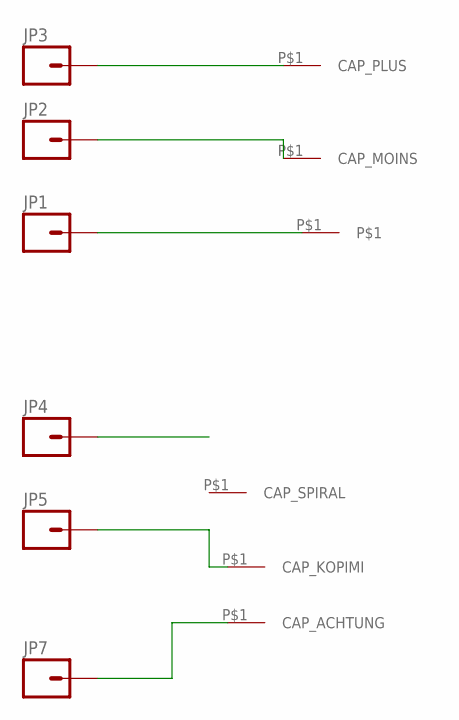
[picture p52: schematic tdlf_08_15_2021_server_top.sch]

Parts:
CAP_MUSH: MUSH; TDLF_CAP_02
CAP_PLUS: TDLF_CAP_PLUS
JP1, JP2, JP3, JP4, JP5, JP7: M01SMD; LUXEON-PAD
U$1: TDLF_CAP_MOINS
U$2: TDLF_CAP_SPIRAL
U$3: TDLF_CAP_KOPIMI
U$4: TDLF_CAP_ACHTUNG

Connections:
CHAMPI: CAP_MUSH.P$1, JP1.P$1
KOPIMI: JP5.P$1, U$3.P$1
MOINS: JP2.P$1, U$1.P$1
unnamed: JP7.P$1, U$4.P$1
PLUS: CAP_PLUS.P$1, JP3.P$1
SPIRAL: JP4.P$1

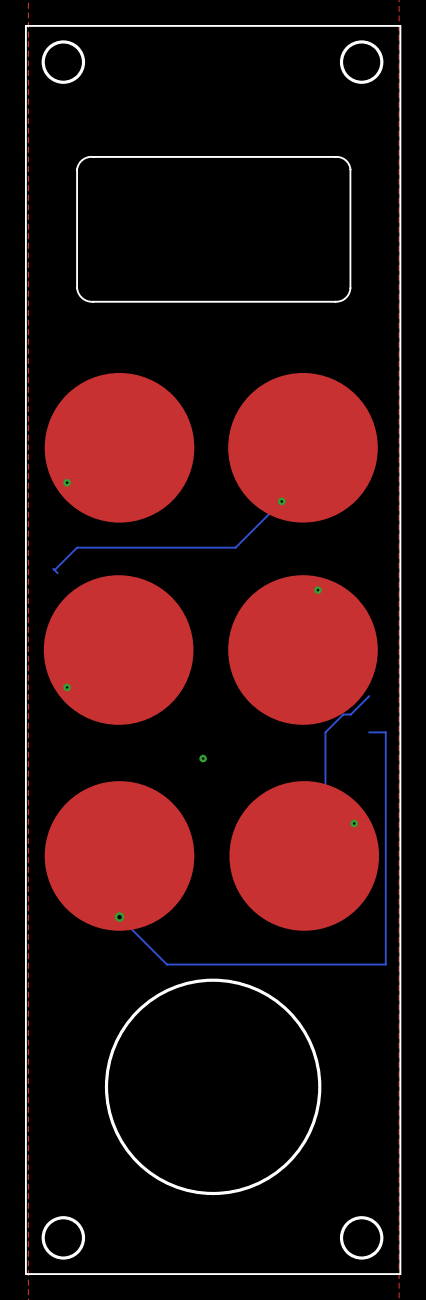
[picture p53: board tdlf_08_15_2021_server_top.brd from above]

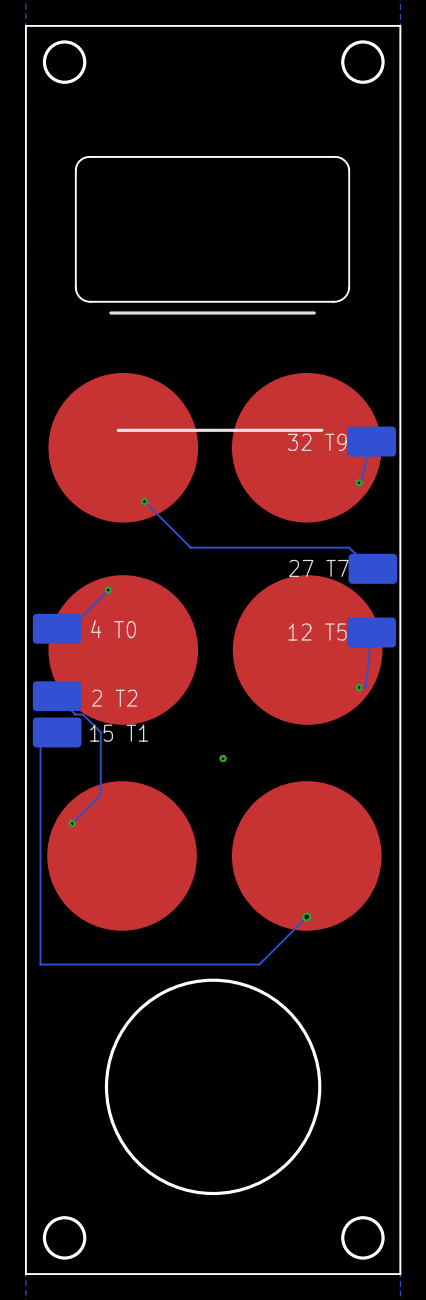
[picture p54: board tdlf_08_15_2021_server_top.brd from below]

Board: 2 copper layers, 30.0 x 100.0 mm, 12 parts (6 on the bottom side), 5 nets.
