alx-1/technologies-de-la-fete/hardware/tdlf_server/tdlf_15_10_2021_server.brd

## EAGLE design hardware/tdlf_server/tdlf_15_10_2021_server.brd (2021-08-26)

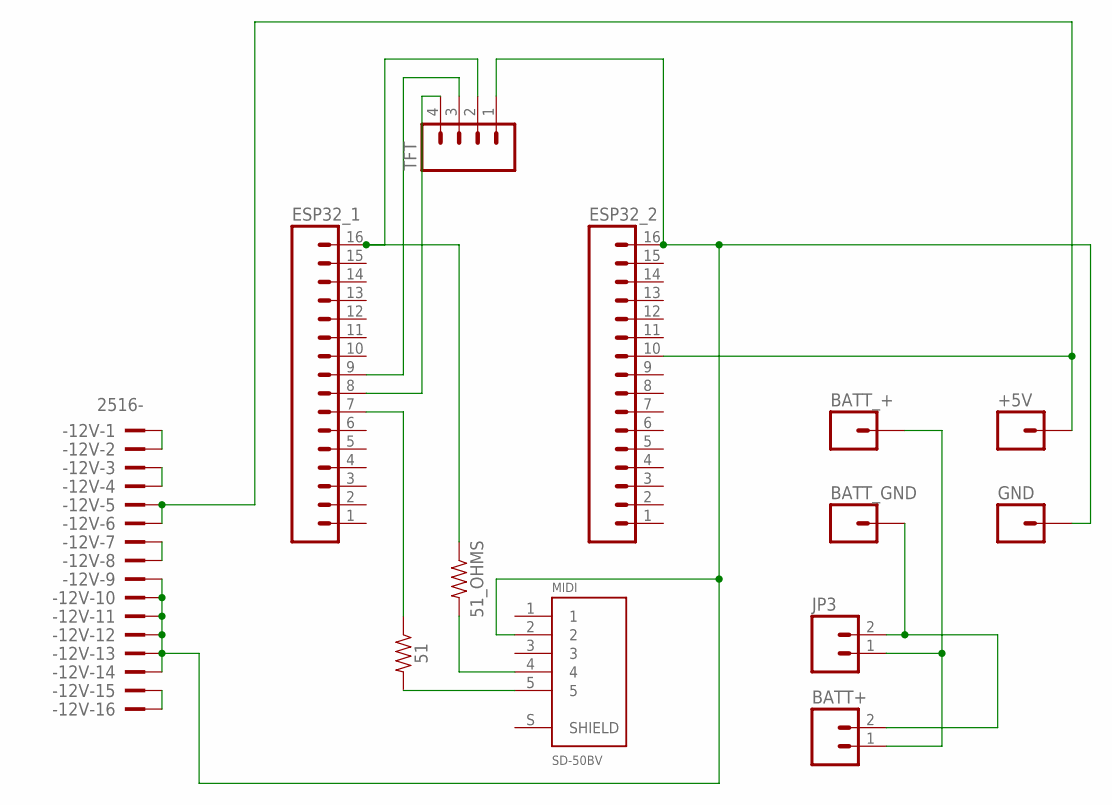
[picture p55: schematic tdlf_15_10_2021_server.sch]

Parts:
51, 51_OHMS: 1206
+5V: M01PTH; 1X01
-12V: 2516-; PAK100/2500-16
BATT+: M02PTH; 1X02
BATT_+: M01PTH; 1X01
BATT_GND: M01PTH; 1X01
ESP32_1, ESP32_2: M16PTH; 1X16
GND: M01PTH; 1X01
JP3: M02PTH; 1X02
MIDI: SD-50BV; CUI_SD-50BV
TFT: M04PTH; 1X04

Connections:
3V: 51_OHMS.2, MIDI.4
3V3: 51_OHMS.1, ESP32_1.16, TFT.2
5V: +5V.1, -12V.5, -12V.6, ESP32_2.10
+12V: -12V.7, -12V.8
+VBATT: BATT+.2, BATT_GND.1, JP3.2
-12V: -12V.15, -12V.16
GND: -12V.9, -12V.10, -12V.11, -12V.12, -12V.13, -12V.14, ESP32_2.16, GND.1, MIDI.2, TFT.1
GND_BATT: BATT+.1, BATT_+.1, JP3.1
unnamed: ESP32_1.9, TFT.3
unnamed: ESP32_1.8, TFT.4
unnamed: 51.1, ESP32_1.7
unnamed: -12V.1, -12V.2
unnamed: -12V.3, -12V.4
PIN27: 51.2, MIDI.5

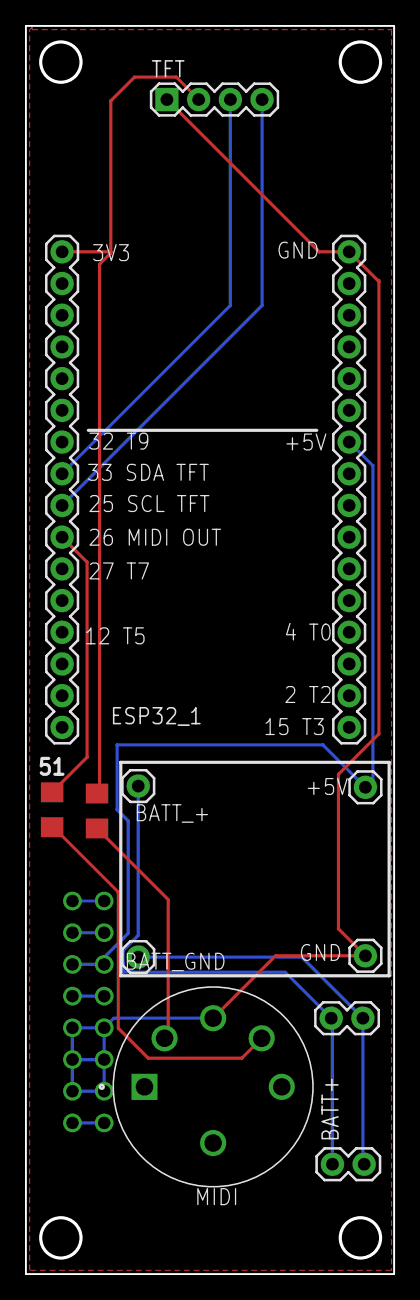
[picture p56: board tdlf_15_10_2021_server.brd from above]

Board: 2 copper layers, 29.5 x 100.0 mm, 13 parts (1 on the bottom side), 14 nets.
