alx-1/technologies-de-la-fete/software/tdlf_sensor/cajita_abierta_tdlf_sensor/cajita_abierta_tdlf_sensor.ino

/*
 *
 *  This sketch sends sensor data to a UDP socket on the tdlf server.
 *  Can be used along with 'chataigne' to interconnect to other software.
 *  It is designed to be used with the 'cajita abierta' ESP32S breakout board
 *  TODO : Add OSC messages
 *
 */
#include <Arduino.h>
#include <analogWrite.h> // From the polyfill analogWrite library for ESP32
#include <WiFi.h>
#include <WiFiUdp.h>

//// For the MPRLS Adafruit pressure sensor ////
//#include <Wire.h> // Already included for the TFT screen
#include "Adafruit_MPRLS.h"
// You dont *need* a reset and EOC pin for most uses, so we set to -1 and don't connect
#define RESET_PIN  -1  // set to any GPIO pin # to hard-reset on begin()
#define EOC_PIN    -1  // set to any GPIO pin to read end-of-conversion by pin
Adafruit_MPRLS mpr = Adafruit_MPRLS(RESET_PIN, EOC_PIN);

// WiFi network name and password: // same as the tdlf server
const char * networkName = "link";
const char * networkPswd = "nidieunimaitre";

//IP address to send UDP data to:
// either use the ip address of the server or 
// a network broadcast address
const char * udpAddress = "192.168.0.255";
const int udpPort = 3333;

//Are we currently connected?
boolean connected = false;

//int nmb = 0; // for testing
int sensorValue = 42;
//int sensorValue1 = 43;
//int sensorValue2 = 44;
//int sensorValue3 = 45;
String myDataType = "s";
String msg = "the medium is...";

//The udp library class
WiFiUDP udp;

////////////// TFT SCREEN //////////
#include <SPI.h>
#include <Wire.h>
#include <Adafruit_GFX.h>
#include <Adafruit_SSD1306.h>
#define SCREEN_WIDTH 128 // OLED display width, in pixels
#define SCREEN_HEIGHT 64 // OLED display height, in pixels
// Declaration for an SSD1306 display connected to I2C (SDA, SCL pins)
#define OLED_RESET     -1 // Reset pin # (or -1 if sharing Arduino reset pin)
Adafruit_SSD1306 display(SCREEN_WIDTH, SCREEN_HEIGHT, &Wire, OLED_RESET);
/////////////////////////////

void setup() {
  Serial.begin(9600);  // works best in testing with 9600 or lower

  //Connect to the WiFi network
  connectToWiFi(networkName, networkPswd);

  // Set resolution for a specific pin
  analogWriteResolution(LED_BUILTIN, 12);
  
  ///////////// TFT DISPLAY /////////////
  // SSD1306_SWITCHCAPVCC = generate display voltage from 3.3V internally
  if (!display.begin(SSD1306_SWITCHCAPVCC, 0x3C)) {
    Serial.println(F("SSD1306 allocation failed"));
    for (;;); // Don't proceed, loop forever
  }
  // Show initial display buffer contents on the screen --
  // the library initializes this with an Adafruit splash screen.
  display.display();
  delay(1000); // Pause for 1 second
  // Clear the buffer
  display.clearDisplay();
  ////////////////////////////////

  ///// Init MPRLS pressure sensor ////
   Serial.println("MPRLS Simple Test");
  if (! mpr.begin()) {
    Serial.println("Failed to communicate with MPRLS sensor, check wiring?");
    while (1) {
      delay(10);
    }
  }
  Serial.println("Found MPRLS sensor");
  /////////////////////////////////////
}

void loop() {
  // Serial.println("testing");

  float pressure_hPa = mpr.readPressure();
  Serial.print("Pressure (hPa): "); Serial.println(pressure_hPa);

  //sensorValue = analogRead(35);
  sensorValue = pressure_hPa-990;
  Serial.println(sensorValue);

  sensorValue = map(sensorValue,-90,90,0,255);
  analogWrite(LED_BUILTIN, sensorValue);
  
  //sensorValue2 = analogRead(33);
  //sensorValue3 = analogRead(32);
  //Serial.println(sensorValue2);
  //Serial.println(sensorValue3);

    if (sensorValue < 100){
      msg = myDataType+String(0)+String(sensorValue);
    }
    else {
      msg = myDataType+String(sensorValue);
    }
    
    // msg = myDataType+String(nmb); // for testing
    // Serial.println(msg);
  
    //only send data when connected
    if(connected){
      //Send a packet
      udp.beginPacket(udpAddress,udpPort);
      udp.print(msg); // "s42" // s is needed as it is the selector message for the tdlf server
      udp.endPacket();
    }
 
    // Display values on the screen
    display.clearDisplay();
    display.setTextSize(1);             // Normal 1:1 pixel scale
    display.setTextColor(WHITE);        // Draw white text
    display.setCursor(5, 0);
    display.print(F("IP: "));// Start at top-left corner
    display.println(WiFi.localIP());// Start at top-left corner
    //display.println(F("Client connected ?"));
    display.setCursor(5, 16);
    display.setTextSize(2);             // Draw 2X-scale text
    display.setTextColor(WHITE);
    // display.invertDisplay(true);
    display.println(F("Sensor: "));
    display.setCursor(5, 40);
    display.println(sensorValue);
    display.display();
    //Serial.println("sensor Value : " + String(sensorValue));
    delay(50);

//    nmb++;
//    if(nmb >= 99){
//      nmb = 0;
//    }
    
  } //  Fin del loop

void connectToWiFi(const char * ssid, const char * pwd){
  Serial.println("Connecting to WiFi network: " + String(ssid));

  // delete old config
  WiFi.disconnect(true);
  //register event handler
  WiFi.onEvent(WiFiEvent);
  
  //Initiate connection
  WiFi.begin(ssid, pwd);

  Serial.println("Waiting for WIFI connection...");
}

//wifi event handler
void WiFiEvent(WiFiEvent_t event){
    switch(event) {
      case ARDUINO_EVENT_WIFI_STA_GOT_IP:
          //When connected set 
          Serial.print("WiFi connected! IP address: ");
          Serial.println(WiFi.localIP());  
          //initializes the UDP state
          //This initializes the transfer buffer
          udp.begin(WiFi.localIP(),udpPort);
          connected = true;
          break;
      case ARDUINO_EVENT_WIFI_STA_DISCONNECTED:
          Serial.println("WiFi lost connection");
          connected = false;
          break;
      default: break;
    }
}
