alx-1/technologies-de-la-fete/(commit log)

2020-10-30 two boards for a capacitive touch based sequencer using the esp32 with ableton-link + hardware midi out
    The midi output is on the 'LED' board.
    [tdlf_01_04_2020_TOUCH.brd, tdlf_01_04_2020_TOUCH.sch, tdlf_16_02_2020_LED.brd, tdlf_16_02_2020_LED.sch]
2020-10-30 pinouts ref for the TTGO esp32
    From espressif
2021-01-11 Touch + buttons
    Link with touchpads + buttons
2021-03-06 tdlf 0.1
    tdlf Server + client , Ableton live sequencer
    [partitions.csv]
2021-04-11 AbletonLive ESP32 with midi notes out
    broadcast for client detection and cfg
    LED feedback
    socket communication
    AbletonLink
    SmartWiFi for config
    new hardware board versions, separated the midi clock + notes out
    [partitions.csv]
2021-04-11 AbletonLink refactoring
    note data sent by sockets to the ESP32 based AbletonLive midi clock for added midi notes output
2021-04-11 ESP32 based AbletonLink enabled midi clock, midi data
    Sent via socket from the modular client
2021-04-11 ESP32 sequencer AbletonLive client for clock and midi out
    [partitions.csv]
2021-04-11 images and dir name changes
    [partitions.csv]
2021-04-11 STEP file for the client module
    [link_tdlf_client.step]
2021-04-11 STEP file now in hardware
    [link_tdlf_client.step]
2021-04-11 recreate tdlf server
    [partitions.csv]
2021-04-12 New LED library thanks to Leon Yuhanov
    https://github.com/leonyuhanov/ESP32APA102Driver
    TODO (done) Flicker LED[0],[4] and [5] are now working flawlessly.
2021-04-12 better sync
    LEDs ok
    Offset solved
    [main.cpp]
2021-04-18 Smart cfg, NVS
    Still errors with the client tasks initiating before getting an IP
    [main.cpp]
2021-04-19 moved LED init code, link + udp tasks indicate works
2021-04-22 Changes to vTaskDelays, step drift correction #1
    [main.cpp]
2021-04-22 get current step from the session state...
    No more delays in the step count
2021-04-30 Better touch handling for the buttons
2021-05-18 node-abletonlink socket.io server + client
2021-05-18 recommitting node ableton link socket.io bridge
2021-08-17 wip
    new boards
    noteDuration
    tapTempo
    [tdlf_03_05_2021_server.brd, tdlf_03_05_2021_server.sch, tdlf_03_05_2021_server_top.brd, tdlf_03_05_2021_server_top.sch, tdlf_08_15_2021_server_top.brd, tdlf_08_15_2021_server_top.sch, tdlf_08_15_2021_server_top_modulaire.brd, tdlf_08_15_2021_server_top_modulaire.sch]
2021-08-22 now with midi notes off for synth tracks
    midi notes off
    long vs short touches detection
    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
    [main.cpp]
2021-08-24 client IPs
    keep track of new client IPs
    update screen
2021-08-26 New image of the tested v.03
    Modular form factor, a smaller standalone exists.
    [tdlf_03_05_2021_server.brd]
2021-10-15 Clean up of tmp files produced by Eagle
    [tdlf_03_05_2021_server.sch]
2021-10-15 Further cleanup
    [link_tdlf_client.step, tdlf_01_04_2020_TOUCH.brd, tdlf_01_04_2020_TOUCH.sch, tdlf_03_05_2021_server_top.brd, tdlf_03_05_2021_server_top.sch, tdlf_08_15_2021_server_top.brd, tdlf_08_15_2021_server_top.sch, tdlf_08_15_2021_server_top_modulaire.brd]
2021-10-23 hacklab21 + moving to CV outputs
    [tdlf_23_10_2021_server.brd, tdlf_23_10_2021_server.sch]
2021-11-10 Moving to TRS for midi and three CV outputs
    For future use with physical interfaces sending sensor data via UDP to the server.
    [tdlf_08_15_2021_server_top_modulaire.brd, tdlf_08_15_2021_server_top_modulaire.sch, tdlf_23_10_2021_server.brd, tdlf_23_10_2021_server.sch, tdlf_server.brd, tdlf_server.sch, tdlf_server_top_modulaire.brd, tdlf_server_top_modulaire.sch]
2021-12-05 Now with 3 CV outputs !
    Midi TRS out works
    CV out : the hardware works but the code needs to be implemented. Help needed :).
    [BOM_tdlf_server.csv, tdlf_server.brd, tdlf_server.sch]
2021-12-05 Images of the new version
    With the cajita abierta wireless sensor interface !
    https://github.com/alx-1/CajitaAbierta
2021-12-08 Version 0.5 ready for CV outputs
    [tdlf_server.brd, tdlf_server.sch, tdlf_server_top_modulaire.brd]
2021-12-08 Adding the wireless sensor client to the main code
    It's called Cajita Abierta, it lets you :
    Connect any type of sensor, send data to the tdlf client through UDP. This is useful (tested for midi) for CC messages and expressive controls.
    [CajitaAbierta.brd, CajitaAbierta.sch]
2021-12-24 CV Clock Out,
    CV Trigger works
    CV Clock Out - needs to be tested
    Update to socket.io 2.4.0
    Update node-abletonlink
    [BOM_tdlf_server.csv, CajitaAbierta.brd, partitions.csv]
2021-12-26 Updated BOM
    [BOM_tdlf_server.csv, BOM_tdlf_server.ods]
2021-12-30 Operation diagrams
    [BOM_tdlf_server.ods]
2022-01-01 Arduino code to set up a WAN on an ESP32
2022-01-01 tdlf ESP32 access point
    Image showing how to connect the tdlf to an ESP32 access point
2022-01-02 Testing CV Pitch out
    [CajitaAbierta.brd]
2022-01-04 Software ENV updates
    Bumped to current ESP-IDF 4.3.2 and Ableton-link 3.0.3
    Refactored the file structure
    Adding CV Pitch output
    [partitions.csv]
2022-01-04 ESP32 dev setup options images
2022-01-05 CV Pitch Output works and tested
2022-01-16 How to assemble the sensor (cajita abierta)
2022-01-21 New adjustments to the case model
    [Cajita_abierta_v05.f3d]
2022-06-09 Now receiving osc midi messages
    Using tinyosc
    [bluebox_side.stl]
2022-10-24 Dusting 'in' - no real change
    Perhaps due to a change in OSX version...cmake creates new files. Did have to follow this for it to compile : https://esp32.com/viewtopic.php?t=16877
2022-10-27 Moving towards a struct to keep track of sequence data
    Thank you https://github.com/maxdee!
    The array of structs keeps track of, note on/off, midiChannel, bar, note number, note length and mute info.
2022-10-27 Small changes to Bansheefy the client
    Not sending bar data (16 steps is ok if you only see one module at a time
    Not sending midi channel values - only one instrument -> the solenoids. Note numbers (0-7) are enough to distinguish between them.
2022-10-27 Starting to adapt the client to the new array of struct
    And receiving and parsing osc midi messages other than sensor data.
2022-12-29 Moving to harmonize code for the blowsuck
    TFT screen functionalities
    UI for the config of CC messages
    [steamy_streamer.brd, steamy_streamer.sch, steamy_streamer_0_2.brd, steamy_streamer_0_2.sch, tdlf_steamy_streamer_top_modulaire.brd, tdlf_steamy_streamer_top_modulaire.sch]
2023-01-22 Update tdlf_cajita_abierta_stick_v0.42.ino
    Accelerometer single + double tap
2023-02-23 Interface for the Cajita Abierta
    Commenting out some of the WT_32 specific code
    Re-enabling support for the Cajita Abierta
    Removing some printouts that speed up the reception of the OSC messages.
2023-06-13 Updating socket.io to 4.6.2
